neuroandriyanov/TemperatureController-CH1/hardware/README.md

# Аппаратные материалы

| Папка | Состав |
|---|---|
| `boards` | `схема_управления.pdf`, `схема_тиристор.pdf`, две спецификации XLSX |
| `boards/ssr_cpu_v2_3` | Производственные Gerber процессорной платы, слои и сверловка |
| `boards/SSR_P_V01` | Gerber силовой платы и файлы сверловки |
| `enclosure` | `cap_termoreg v9.stl`, геометрия доступной детали корпуса |
| `photos` | Реальные фотографии плат и устройства |

Имена и ревизии исходных производственных файлов сохранены. Редактируемые проекты EDA и параметрическая CAD-модель в исходном наборе не найдены; PDF/Gerber/STL не заменяют эти оригиналы. В комплект включена только имеющаяся STL-деталь, полнота печатного корпуса не утверждается.

## Отличие испытанного экземпляра

Во время калибровки 4–20 мА R17 изменён с **62 кОм по схеме на 47 кОм**. RP1 возвращён примерно на два оборота от достигнутого крайнего положения. Это изменение конкретной платы, подтверждённое ходом испытания и измерениями; PDF и BOM намеренно сохранены в исходной ревизии. Перед изготовлением новой платы пересчитайте тракт и проверьте диапазон, не считайте исходный BOM автоматически обновлённым.

Подробная привязка выводов STM32, питания, UART, MAX31856, ACS712 и AD7741 — [HARDWARE.md](../firmware/docs/HARDWARE.md). Программные защиты не заменяют независимое силовое отключение. Тепловая проверка в комплекте относится к наружной поверхности корпуса, а не к закрытому радиатору.

Аппаратные файлы: [CERN-OHL-P-2.0](../LICENSES/CERN-OHL-P-2.0.txt). Авторские фотографии: [MIT](../LICENSE).
