neuroandriyanov/TemperatureController-CH1/apps/thermal_monitor/fixtures/README.en.md

# UTi260B OCR fixture

[Русский](README.md) | **English**

Original, unchanged frame from 2026-11-05: min 22.2 °C, max 33.2 °C, center 27.9 °C.
Original photograph, MIT. Used by OCR and rotation tests without camera access.
