neuroandriyanov/TemperatureController-CH1/knowledge/OPEN_QUESTIONS.md

# Неподтверждённое и следующие исследования

1. Реальная температура закрытого радиатора и симистора: наружные термограммы не дают её. Нужен прямой доступ/датчик и учёт излучательной способности.
2. Длительный прогон на разных нагрузках, восстановление AUTO/MANUAL после полного снятия всех питаний, физическая проверка аварий и независимого отключения. Не заменять стендовый эксперимент native-тестами.
3. Сравнение внутреннего и внешнего холодного спая при одинаковом измеренном температурном поле клемм. Последний PID-опыт выполнен с внутренним CJ.
4. Причина влияния USB в калибровочных цепях: наблюдение есть, путь паразитного тока отдельно не измерялся. В термопарной серии эффект контакта не полностью отделён от общей земли.
5. Полноценная четырёхпроводная Pt100-проверка и неопределённость всей цепи. Последняя серия использовала два провода и перемычки.
6. Эвристика меню UTi260B: нужны положительные кадры меню и отрицательные обычной сцены. Нельзя просто отключить проверку во всём live-декодере, основываясь на четырёх просмотренных термограммах.
7. Оригинальные редактируемые EDA/CAD-файлы отсутствуют в комплекте. Обновление R17 в новой ревизии производства следует выполнить после проверки схемы и диапазона; старые Gerber/BOM сами не обновились.
8. Полная сверка netlist/номеров компонентов с PDF перед автоматическим импортом связей в базу сайта. Пока неизвестные связи не придуманы.
