neuroandriyanov/TemperatureController-CH1/firmware/docs/REGISTERS.en.md

# Register map 2.4

[Русский](REGISTERS.md) | **English**

The source map is generated by `scripts/register_map.py` from `app/config.def`. All addresses are zero-based; numbers are decimal. Value / divisor = physical quantity. Ranges and defaults below use transmitted integer units. This English sidecar translates descriptions without changing addresses or numerical fields.

## Holding: FC03 / FC06 / FC16

| Address | Name | Type | Divisor / unit | Default | Min…max | Purpose |
|---:|---|---|---|---:|---|---|
| 0 | `SETPOINT` | s16 | 10 / °C | 650 | -2000…18000 | Temperature setpoint |
| 1 | `TC_TYPE` | u16 | 1 / enum | 3 | 0…7 | Thermocouple: 0=B, 1=E, 2=J, 3=K, 4=N, 5=R, 6=S, 7=T |
| 2 | `CJ_MODE` | u16 | 1 / enum | 0 | 0…1 | Compensation: 0=internal MAX31856, 1=external PT100 through 4–20 mA |
| 3 | `FILTER_60HZ` | u16 | 1 / enum | 0 | 0…1 | Mains filter: 0=50 Hz, 1=60 Hz |
| 4 | `AVERAGE_LOG2` | u16 | 1 / log2 | 2 | 0…4 | MAX31856 averaging: 0/1/2/3/4 = 1/2/4/8/16 |
| 5 | `TC_TIMEOUT_MS` | u16 | 1 / ms | 3000 | 1500…10000 | Maximum thermocouple age / conversion timeout |
| 6 | `CJ_OFFSET_C100` | s16 | 100 / °C | 0 | -800…793 | Internal cold-junction offset; rounded to 0.0625 °C |
| 7 | `TC_OFFSET_C100` | s16 | 100 / °C | 0 | -10000…10000 | Final thermocouple-temperature offset |
| 8 | `KP_1000` | u16 | 1000 / %/°C | 2700 | 0…60000 | Kp |
| 9 | `KI_1000` | u16 | 1000 / %/(°C·s) | 100 | 0…60000 | Ki |
| 10 | `KD_100` | u16 | 100 / %·s/°C | 0 | 0…60000 | Kd |
| 11 | `D_FILTER_MS` | u16 | 1 / ms | 1000 | 0…10000 | Derivative-filter time constant |
| 12 | `PID_INTERVAL_MS` | u16 | 1 / ms | 500 | 100…5000 | PID calculation interval |
| 13 | `BURST_PERIOD_MS` | u16 | 1 / ms low word | 2000 | 0…65535 | Low 16 bits of PWM period; together with holding 46: 2000…300000 ms |
| 14 | `OUTPUT_LIMIT_100` | u16 | 100 / % | 10000 | 0…10000 | Output limit |
| 15 | `RAMP_C10_MIN` | u16 | 10 / °C/min | 0 | 0…10000 | Working-setpoint slew rate; 0 = unlimited |
| 16 | `PROCESS_MIN_C10` | s16 | 10 / °C | -500 | -2000…17990 | Lower process limit |
| 17 | `PROCESS_MAX_C10` | s16 | 10 / °C | 1500 | -1990…18000 | Upper process limit |
| 18 | `TOLERANCE_LOW_C10` | u16 | 10 / °C | 100 | 0…18000 | Lower tolerance for K1 relay |
| 19 | `TOLERANCE_HIGH_C10` | u16 | 10 / °C | 100 | 0…18000 | Upper tolerance for K1 relay |
| 20 | `CURRENT_GAIN_UA` | u16 | 1 / µA/count | 20350 | 1000…60000 | ACS712-30A current gain after board divider |
| 21 | `CURRENT_OFFSET_MA` | s16 | 1 / mA | 0 | -5000…5000 | RMS current offset after scaling |
| 22 | `CURRENT_NOISE_C100` | u16 | 100 / ADC count | 0 | 0…20000 | Zero-current noise; subtracted in quadrature |
| 23 | `OVERCURRENT_MA` | u16 | 1 / mA | 16000 | 100…30000 | Overcurrent threshold |
| 24 | `OVERCURRENT_MS` | u16 | 1 / ms | 200 | 0…5000 | Overcurrent delay after RMS acquisition |
| 25 | `OFF_CURRENT_MA` | u16 | 1 / mA | 500 | 0…30000 | Current threshold with output off |
| 26 | `OFF_CURRENT_MS` | u16 | 1 / ms | 1500 | 300…10000 | Fault delay for current with output off |
| 27 | `OPEN_CURRENT_MA` | u16 | 1 / mA | 0 | 0…30000 | Minimum current with heater on; 0 disables open-heater diagnosis |
| 28 | `OPEN_CURRENT_MS` | u16 | 1 / ms | 3000 | 300…30000 | Accumulated duration of valid ON windows with insufficient current; OFF excluded, normal ON current resets counter |
| 29 | `COMM_TIMEOUT_MS` | u16 | 1 / ms | 5000 | 0…60000 | Master communication timeout; 0 disables monitoring |
| 30 | `CURRENT_TIMEOUT_MS` | u16 | 1 / ms | 600 | 300…5000 | Maximum current-measurement age |
| 31 | `EXT_TEMP_4_C10` | s16 | 10 / °C | -100 | -2000…18000 | PT100 transmitter temperature at 4 mA |
| 32 | `EXT_TEMP_20_C10` | s16 | 10 / °C | 1500 | -2000…18000 | PT100 transmitter temperature at 20 mA |
| 33 | `EXT_VOLT_4_MV` | u16 | 1 / mV | 517 | 0…2450 | Measured AD7741 voltage at reference 4 mA |
| 34 | `EXT_VOLT_20_MV` | u16 | 1 / mV | 2274 | 50…2500 | Measured AD7741 voltage at reference 20 mA |
| 35 | `EXT_OFFSET_UA` | s16 | 1 / µA | 0 | -4000…4000 | Additional loop-current offset |
| 36 | `EXT_TEMP_OFFSET_C100` | s16 | 100 / °C | 0 | -10000…10000 | PT100 temperature offset |
| 37 | `EXT_TIMEOUT_MS` | u16 | 1 / ms | 1000 | 300…10000 | Maximum external-sensor age |
| 38 | `EXT_LOW_UA` | u16 | 1 / µA | 3600 | 0…4000 | Lower permitted loop-current limit |
| 39 | `EXT_HIGH_UA` | u16 | 1 / µA | 21000 | 20000…24000 | Upper permitted loop-current limit |
| 40 | `CALIBRATION_FLAGS` | u16 | 1 / bits | 0 | 0…3 | Calibration confirmation: bit0=ACS712, bit1=PT100/4–20 mA; write 1 or 3 after verification |
| 41 | `PREFERRED_MODE` | u16 | 1 / enum | 1 | 0…2 | Window selection: 0=STOP, 1=AUTO PID, 2=MANUAL; actual saved mode is holding 45 |
| 42 | `MANUAL_PRESET_100` | u16 | 100 / % | 0 | 0…10000 | Saved manual output; applied by a separate start command |
| 43 | `RELAY_FUNCTION` | u16 | 1 / enum | 1 | 0…6 | K1: 0=off, 1=in tolerance, 2=in tolerance after warm-up, 3=any fault, 4=overcurrent, 5=open heater, 6=instrument fault |
| 44 | `SOAK_SECONDS` | u16 | 1 / s | 600 | 0…65535 | Warm-up dwell after first entry into tolerance; 0=no delay |
| 45 | `POWERUP_MODE` | u16 | 1 / enum | 0 | 0…2 | Power-up mode: 0=STOP, 1=AUTO, 2=MANUAL; changed by commands 256 and saved automatically; direct write of a different value prohibited |
| 46 | `BURST_PERIOD_MS_HIGH` | u16 | 1 / ms high word | 0 | 0…4 | High 16 bits of PWM period; period = (holding46 << 16) \| holding13; 2000…300000 ms. Write both parts atomically with FC16 0…46 |

## Commands

| Address | Command | Values |
|---:|---|---|
| 256 (0x100) | Mode | 0 STOP / 1 AUTO / 2 MANUAL |
| 257 | Manual output | 0…10000 = 0…100.00 % |
| 258 | Save EEPROM | 0xA55A |
| 259 | Fault reset | 0xC1EA, STOP only and no active causes |
| 260 | Current test up to 10 s | 0xCA10; read returns remaining ms. Conditions and limits in PROTOCOL.en.md |

FC16 261…263: atomic setpoint, lower and upper tolerance (0.1 °C), saving EEPROM and retaining the current mode. Check input 37=2 and dirty=0; EEPROM writing briefly pauses output.

## Input: FC04

| Address | Name | Type | Divisor / unit | Purpose |
|---:|---|---|---|---|
| 0 | `firmware_version` | u16 | 1 / hex | 0x0205 = version 2.5 |
| 1 | `protocol_version` | u16 | 1 / hex | 0x0204 = map 2.4; previous addresses retained |
| 2 | `slave_address` | u16 | 1 / address | Active address; 0 = invalid |
| 3 | `rotary_raw` | u16 | 1 / hex | Current state of both switches |
| 4 | `mode` | u16 | 1 / enum | 0=STOP, 1=AUTO, 2=MANUAL, 3=limited current test; start only with command 260 |
| 5 | `gate` | u16 | 1 / bool | PA3 state |
| 6 | `relay` | u16 | 1 / bool | K1 state |
| 7 | `cj_mode` | u16 | 1 / enum | Selected compensation source |
| 8…9 | `active_faults` | u32 | 1 / bits | Current reasons blocking startup |
| 10…11 | `latched_faults` | u32 | 1 / bits | Latched faults |
| 12…13 | `uptime_s` | u32 | 1 / s | HAL tick / 1000; resets when tick wraps after approximately 49.7 days |
| 14…15 | `temperature_sample` | u32 | 1 / counter | Number of the MAX31856 conversion read |
| 16 | `temperature` | s16 | 10 / °C | Temperature after offset |
| 17 | `cold_junction` | s16 | 100 / °C | Compensation used by MAX31856; not the internal sensor in external mode |
| 18 | `external_temperature` | s16 | 10 / °C | PT100 temperature after scaling and offset |
| 19 | `setpoint` | s16 | 10 / °C | Requested setpoint |
| 20 | `working_setpoint` | s16 | 10 / °C | Setpoint after slew limiting |
| 21 | `output` | u16 | 100 / % | Requested output percentage |
| 22 | `current` | u16 | 1 / mA | AC RMS over 200 ms, including burst-control pauses |
| 23 | `adc_mean` | u16 | 1 / count | ADC mean, zero baseline |
| 24 | `adc_rms` | u16 | 10 / count | AC-component RMS before calibration |
| 25 | `adc_min` | u16 | 1 / count | Minimum over window |
| 26 | `adc_max` | u16 | 1 / count | Maximum over window |
| 27 | `external_voltage` | u16 | 1 / mV | AD7741 input |
| 28 | `loop_current` | u16 | 1 / µA | Converted 4–20 mA current; negative value displayed as 0 |
| 29…30 | `external_frequency` | u32 | 1 / Hz | FOUT frequency |
| 31 | `max_status` | u16 | 1 / bits | MAX31856 SR low byte; 0x100=SPI, 0x200=DRDY timeout |
| 32 | `temperature_age` | u16 | 1 / ms | Age; 65535 when invalid or saturated |
| 33 | `current_age` | u16 | 1 / ms | Current age |
| 34 | `external_age` | u16 | 1 / ms | External-sensor age |
| 35 | `measurement_flags` | u16 | 1 / bits | bit0=TC, bit1=current, bit2=external: last conversion successful; also check age and faults |
| 36 | `config_dirty` | u16 | 1 / bool | RAM settings differ from saved settings |
| 37 | `storage_status` | u16 | 1 / enum | 0=loaded, 1=pending, 2=saved, 3=defaults, 4=I2C/verification error |
| 38…39 | `saved_sequence` | u32 | 1 / counter | EEPROM record sequence |
| 40…41 | `config_revision` | u32 | 1 / counter | RAM configuration revision |
| 42…43 | `adc_overruns` | u32 | 1 / counter | Missed ADC/DMA windows |
| 44 | `pid_integral` | s16 | 100 / % | Integral term |
| 45 | `pid_derivative` | s16 | 100 / °C/s | Filtered negative PV derivative; saturates to s16 |
| 46 | `current_sensor_amperes` | u16 | 1 / A | Installed ACS712 variant: 30 |
| 47 | `calibration_flags` | u16 | 1 / bits | Copy of holding 40 |
| 48…49 | `modbus_valid` | u32 | 1 / counter | Successful requests on the queried port before the current request |
| 50…51 | `modbus_crc_errors` | u32 | 1 / counter | CRC errors on this port |
| 52…53 | `modbus_malformed` | u32 | 1 / counter | Length errors / TX timeout on this port |
| 54…55 | `modbus_exceptions` | u32 | 1 / counter | Exception replies on this port |
| 56…57 | `modbus_framing_errors` | u32 | 1 / counter | UART/gap/overflow errors or extra bytes while a frame is ready |
| 58 | `relay_function` | u16 | 1 / enum | Copy of holding 43 |
| 59 | `soak_state` | u16 | 1 / enum | 0=STOP, 1=waiting for tolerance, 2=dwell, 3=warm-up complete |
| 60 | `soak_remaining` | u16 | 1 / s | Remaining dwell; full duration before first entry into tolerance |
| 61 | `powerup_mode` | u16 | 1 / enum | Copy of holding 45; confirm saving through input 37 |
| 62 | `boot_status` | u16 | 1 / enum | 0=normal operation, 1=waiting for sensors after power-up, 2=mode restored, 3=restoration canceled |
| 63 | `config_count` | u16 | 1 / registers | Number of settings: 47 |
