neuroandriyanov/TemperatureController-CH1/firmware/docs/REGISTERS.md

# Карта регистров 2.4

Создано `scripts/register_map.py` из `app/config.def`. Все адреса нулевые, числа десятичные. Значение / делитель = физическая величина. Диапазоны и defaults ниже даны в передаваемых целых единицах.

## Holding: FC03 / FC06 / FC16

| Адрес | Имя | Тип | Делитель / единица | Default | Min…max | Назначение |
|---:|---|---|---|---:|---|---|
| 0 | `SETPOINT` | s16 | 10 / °C | 650 | -2000…18000 | Уставка температуры |
| 1 | `TC_TYPE` | u16 | 1 / enum | 3 | 0…7 | Термопара: 0=B, 1=E, 2=J, 3=K, 4=N, 5=R, 6=S, 7=T |
| 2 | `CJ_MODE` | u16 | 1 / enum | 0 | 0…1 | Компенсация: 0=внутренняя MAX31856, 1=внешняя PT100 через 4–20 мА |
| 3 | `FILTER_60HZ` | u16 | 1 / enum | 0 | 0…1 | Сетевой фильтр: 0=50 Гц, 1=60 Гц |
| 4 | `AVERAGE_LOG2` | u16 | 1 / log2 | 2 | 0…4 | Усреднение MAX31856: 0/1/2/3/4 = 1/2/4/8/16 |
| 5 | `TC_TIMEOUT_MS` | u16 | 1 / ms | 3000 | 1500…10000 | Максимальный возраст термопары / тайм-аут преобразования |
| 6 | `CJ_OFFSET_C100` | s16 | 100 / °C | 0 | -800…793 | Поправка внутреннего холодного спая; округляется к 0,0625 °C |
| 7 | `TC_OFFSET_C100` | s16 | 100 / °C | 0 | -10000…10000 | Поправка итоговой температуры термопары |
| 8 | `KP_1000` | u16 | 1000 / %/°C | 2700 | 0…60000 | Kp |
| 9 | `KI_1000` | u16 | 1000 / %/(°C·s) | 100 | 0…60000 | Ki |
| 10 | `KD_100` | u16 | 100 / %·s/°C | 0 | 0…60000 | Kd |
| 11 | `D_FILTER_MS` | u16 | 1 / ms | 1000 | 0…10000 | Постоянная фильтра производной |
| 12 | `PID_INTERVAL_MS` | u16 | 1 / ms | 500 | 100…5000 | Период расчёта PID |
| 13 | `BURST_PERIOD_MS` | u16 | 1 / ms low word | 2000 | 0…65535 | Младшие 16 бит периода ШИМ; совместно с holding 46: 2000…300000 мс |
| 14 | `OUTPUT_LIMIT_100` | u16 | 100 / % | 10000 | 0…10000 | Ограничение мощности |
| 15 | `RAMP_C10_MIN` | u16 | 10 / °C/min | 0 | 0…10000 | Скорость изменения рабочей уставки; 0 = без ограничения |
| 16 | `PROCESS_MIN_C10` | s16 | 10 / °C | -500 | -2000…17990 | Нижний технологический предел |
| 17 | `PROCESS_MAX_C10` | s16 | 10 / °C | 1500 | -1990…18000 | Верхний технологический предел |
| 18 | `TOLERANCE_LOW_C10` | u16 | 10 / °C | 100 | 0…18000 | Нижний допуск для реле K1 |
| 19 | `TOLERANCE_HIGH_C10` | u16 | 10 / °C | 100 | 0…18000 | Верхний допуск для реле K1 |
| 20 | `CURRENT_GAIN_UA` | u16 | 1 / µA/count | 20350 | 1000…60000 | Коэффициент тока ACS712-30A после делителя платы |
| 21 | `CURRENT_OFFSET_MA` | s16 | 1 / mA | 0 | -5000…5000 | Поправка RMS тока после пересчёта |
| 22 | `CURRENT_NOISE_C100` | u16 | 100 / ADC count | 0 | 0…20000 | Шум при нулевом токе; вычитается по квадратам |
| 23 | `OVERCURRENT_MA` | u16 | 1 / mA | 16000 | 100…30000 | Порог перегрузки |
| 24 | `OVERCURRENT_MS` | u16 | 1 / ms | 200 | 0…5000 | Задержка перегрузки после получения RMS |
| 25 | `OFF_CURRENT_MA` | u16 | 1 / mA | 500 | 0…30000 | Порог тока при выключенном выходе |
| 26 | `OFF_CURRENT_MS` | u16 | 1 / ms | 1500 | 300…10000 | Задержка ошибки тока при выключенном выходе |
| 27 | `OPEN_CURRENT_MA` | u16 | 1 / mA | 0 | 0…30000 | Минимальный ток включённого нагревателя; 0 отключает диагностику обрыва |
| 28 | `OPEN_CURRENT_MS` | u16 | 1 / ms | 3000 | 300…30000 | Накопленное время достоверных ON-окон без достаточного тока; OFF не учитывается, нормальный ON-ток сбрасывает счётчик |
| 29 | `COMM_TIMEOUT_MS` | u16 | 1 / ms | 5000 | 0…60000 | Потеря связи с мастером; 0 отключает контроль |
| 30 | `CURRENT_TIMEOUT_MS` | u16 | 1 / ms | 600 | 300…5000 | Максимальный возраст измерения тока |
| 31 | `EXT_TEMP_4_C10` | s16 | 10 / °C | -100 | -2000…18000 | Температура преобразователя PT100 при 4 мА |
| 32 | `EXT_TEMP_20_C10` | s16 | 10 / °C | 1500 | -2000…18000 | Температура преобразователя PT100 при 20 мА |
| 33 | `EXT_VOLT_4_MV` | u16 | 1 / mV | 517 | 0…2450 | Измеренное напряжение AD7741 при эталонных 4 мА |
| 34 | `EXT_VOLT_20_MV` | u16 | 1 / mV | 2274 | 50…2500 | Измеренное напряжение AD7741 при эталонных 20 мА |
| 35 | `EXT_OFFSET_UA` | s16 | 1 / µA | 0 | -4000…4000 | Дополнительная поправка тока петли |
| 36 | `EXT_TEMP_OFFSET_C100` | s16 | 100 / °C | 0 | -10000…10000 | Поправка температуры PT100 |
| 37 | `EXT_TIMEOUT_MS` | u16 | 1 / ms | 1000 | 300…10000 | Максимальный возраст внешнего датчика |
| 38 | `EXT_LOW_UA` | u16 | 1 / µA | 3600 | 0…4000 | Нижняя допустимая граница тока петли |
| 39 | `EXT_HIGH_UA` | u16 | 1 / µA | 21000 | 20000…24000 | Верхняя допустимая граница тока петли |
| 40 | `CALIBRATION_FLAGS` | u16 | 1 / bits | 0 | 0…3 | Подтверждение калибровки: bit0=ACS712, bit1=PT100/4–20 мА; после проверки записать 1 или 3 |
| 41 | `PREFERRED_MODE` | u16 | 1 / enum | 1 | 0…2 | Выбор в окне: 0=STOP, 1=AUTO PID, 2=MANUAL; действующий сохранённый режим — holding 45 |
| 42 | `MANUAL_PRESET_100` | u16 | 100 / % | 0 | 0…10000 | Сохранённая ручная мощность; применяется отдельной командой запуска |
| 43 | `RELAY_FUNCTION` | u16 | 1 / enum | 1 | 0…6 | K1: 0=выключено, 1=в допуске, 2=в допуске после прогрева, 3=любая ошибка, 4=перегрузка, 5=обрыв нагревателя, 6=ошибка прибора |
| 44 | `SOAK_SECONDS` | u16 | 1 / s | 600 | 0…65535 | Выдержка прогрева после первого попадания в допуск; 0=без задержки |
| 45 | `POWERUP_MODE` | u16 | 1 / enum | 0 | 0…2 | Режим после питания: 0=STOP, 1=AUTO, 2=MANUAL; меняется командами 256 и сохраняется автоматически, прямая запись другого значения запрещена |
| 46 | `BURST_PERIOD_MS_HIGH` | u16 | 1 / ms high word | 0 | 0…4 | Старшие 16 бит периода ШИМ; период = (holding46 << 16) | holding13; 2000…300000 мс. Обе части записывать атомарно FC16 0…46 |

## Команды

| Адрес | Команда | Значения |
|---:|---|---|
| 256 (0x100) | Режим | 0 STOP / 1 AUTO / 2 MANUAL |
| 257 | Ручная мощность | 0…10000 = 0…100,00 % |
| 258 | Сохранить EEPROM | 0xA55A |
| 259 | Сброс аварии | 0xC1EA, только STOP и отсутствие активных причин |
| 260 | Тест тока до 10 с | 0xCA10; чтение — оставшиеся мс. Условия и ограничения в PROTOCOL.md |

FC16 261…263: атомарно уставка, нижний и верхний допуск (0,1 °C), с сохранением EEPROM и текущего режима. Проверить input 37=2 и dirty=0; запись даёт краткую паузу выхода на время EEPROM.

## Input: FC04

| Адрес | Имя | Тип | Делитель / единица | Назначение |
|---:|---|---|---|---|
| 0 | `firmware_version` | u16 | 1 / hex | 0x0205 = версия 2.5 |
| 1 | `protocol_version` | u16 | 1 / hex | 0x0204 = карта 2.4; прежние адреса сохранены |
| 2 | `slave_address` | u16 | 1 / address | Действующий адрес; 0 = недопустим |
| 3 | `rotary_raw` | u16 | 1 / hex | Текущее состояние двух переключателей |
| 4 | `mode` | u16 | 1 / enum | 0=STOP, 1=AUTO, 2=MANUAL, 3=ограниченный тест тока; запуск только командой 260 |
| 5 | `gate` | u16 | 1 / bool | Состояние PA3 |
| 6 | `relay` | u16 | 1 / bool | Состояние K1 |
| 7 | `cj_mode` | u16 | 1 / enum | Выбранный источник компенсации |
| 8…9 | `active_faults` | u32 | 1 / bits | Текущие причины запрета запуска |
| 10…11 | `latched_faults` | u32 | 1 / bits | Зафиксированные аварии |
| 12…13 | `uptime_s` | u32 | 1 / s | HAL tick / 1000; сброс при переполнении tick примерно через 49,7 суток |
| 14…15 | `temperature_sample` | u32 | 1 / counter | Номер прочитанного преобразования MAX31856 |
| 16 | `temperature` | s16 | 10 / °C | Температура после поправки |
| 17 | `cold_junction` | s16 | 100 / °C | Компенсация, использованная MAX31856; при внешнем режиме это не внутренний датчик |
| 18 | `external_temperature` | s16 | 10 / °C | Температура PT100 после масштабирования и поправки |
| 19 | `setpoint` | s16 | 10 / °C | Заданная уставка |
| 20 | `working_setpoint` | s16 | 10 / °C | Уставка после ограничения скорости |
| 21 | `output` | u16 | 100 / % | Заданная мощность |
| 22 | `current` | u16 | 1 / mA | AC RMS за 200 мс, включая паузы пакетного управления |
| 23 | `adc_mean` | u16 | 1 / count | Среднее АЦП, нулевая линия |
| 24 | `adc_rms` | u16 | 10 / count | RMS переменной составляющей до калибровки |
| 25 | `adc_min` | u16 | 1 / count | Минимум за окно |
| 26 | `adc_max` | u16 | 1 / count | Максимум за окно |
| 27 | `external_voltage` | u16 | 1 / mV | Вход AD7741 |
| 28 | `loop_current` | u16 | 1 / µA | Пересчитанный ток 4–20 мА; отрицательное значение отображается как 0 |
| 29…30 | `external_frequency` | u32 | 1 / Hz | Частота FOUT |
| 31 | `max_status` | u16 | 1 / bits | Младший байт SR MAX31856; 0x100=SPI, 0x200=DRDY timeout |
| 32 | `temperature_age` | u16 | 1 / ms | Возраст; 65535 при недостоверности или насыщении |
| 33 | `current_age` | u16 | 1 / ms | Возраст тока |
| 34 | `external_age` | u16 | 1 / ms | Возраст внешнего датчика |
| 35 | `measurement_flags` | u16 | 1 / bits | bit0=TC, bit1=current, bit2=external: последнее преобразование успешно; также проверять возраст и аварии |
| 36 | `config_dirty` | u16 | 1 / bool | Настройки в RAM отличаются от сохранённых |
| 37 | `storage_status` | u16 | 1 / enum | 0=загружено, 1=ожидание, 2=сохранено, 3=defaults, 4=ошибка I2C/проверки |
| 38…39 | `saved_sequence` | u32 | 1 / counter | Номер записи EEPROM |
| 40…41 | `config_revision` | u32 | 1 / counter | Номер изменения настроек в RAM |
| 42…43 | `adc_overruns` | u32 | 1 / counter | Пропуски окон ADC/DMA |
| 44 | `pid_integral` | s16 | 100 / % | Интегральная составляющая |
| 45 | `pid_derivative` | s16 | 100 / °C/s | Отфильтрованная отрицательная производная PV; насыщается до s16 |
| 46 | `current_sensor_amperes` | u16 | 1 / A | Установленный вариант ACS712: 30 |
| 47 | `calibration_flags` | u16 | 1 / bits | Повтор holding 40 |
| 48…49 | `modbus_valid` | u32 | 1 / counter | Успешные запросы на читаемом порту до текущего запроса |
| 50…51 | `modbus_crc_errors` | u32 | 1 / counter | CRC ошибки этого порта |
| 52…53 | `modbus_malformed` | u32 | 1 / counter | Ошибки длины/тайм-аут TX этого порта |
| 54…55 | `modbus_exceptions` | u32 | 1 / counter | Ответы исключения этого порта |
| 56…57 | `modbus_framing_errors` | u32 | 1 / counter | Ошибки UART/пауз/переполнения/лишние байты во время готового кадра |
| 58 | `relay_function` | u16 | 1 / enum | Повтор holding 43 |
| 59 | `soak_state` | u16 | 1 / enum | 0=STOP, 1=ожидание допуска, 2=выдержка, 3=прогрев завершён |
| 60 | `soak_remaining` | u16 | 1 / s | Оставшееся время выдержки; до первого допуска полное время |
| 61 | `powerup_mode` | u16 | 1 / enum | Повтор holding 45; факт сохранения проверять по input 37 |
| 62 | `boot_status` | u16 | 1 / enum | 0=обычная работа, 1=ожидание датчиков после питания, 2=режим восстановлен, 3=восстановление отменено |
| 63 | `config_count` | u16 | 1 / registers | Число настроек: 47 |
