neuroandriyanov/TemperatureController-CH1/apps/thermal_monitor/fixtures/README.md

# UTi260B OCR fixture

**Русский** | [English](README.en.md)

Реальный неизменённый кадр 05.11.2026: min 22,2 °C, max 33,2 °C, center 27,9 °C.
Авторский снимок, MIT. Используется в тестах OCR и поворота без доступа к камере.
