neuroandriyanov/TemperatureController-CH1/apps/thermal_monitor/fixtures/uti260b_osd.png

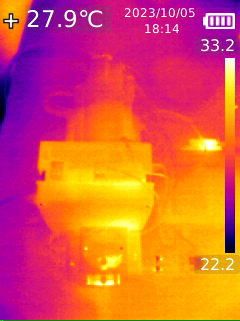
apps/thermal_monitor/fixtures/uti260b_osd.png
