neuroandriyanov/TemperatureController-CH1/hardware/photos/1.JPG

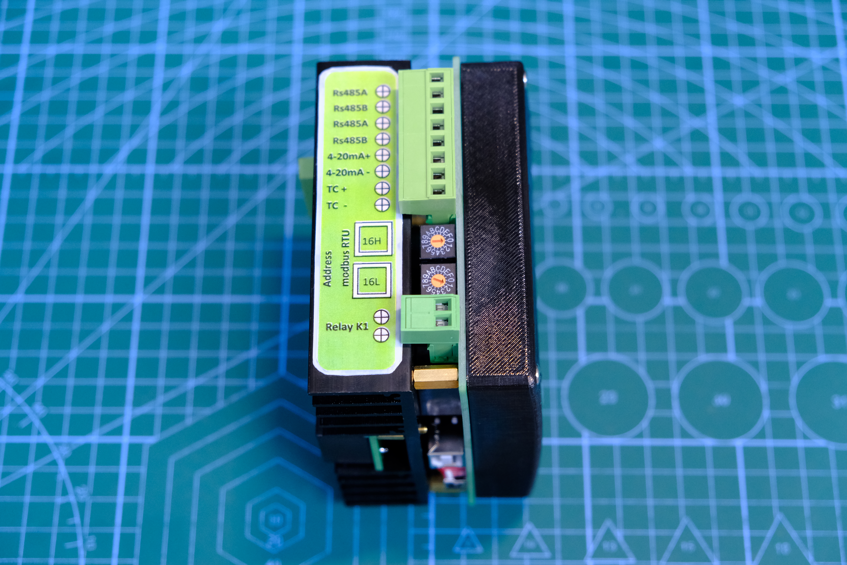
hardware/photos/1.JPG
