neuroandriyanov/TemperatureController-CH1/hardware/photos/2.JPG

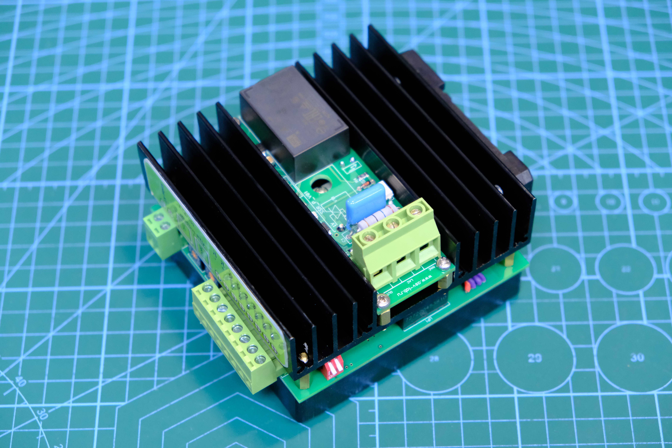
hardware/photos/2.JPG
