neuroandriyanov/TemperatureController-CH1/hardware/photos/3.JPG

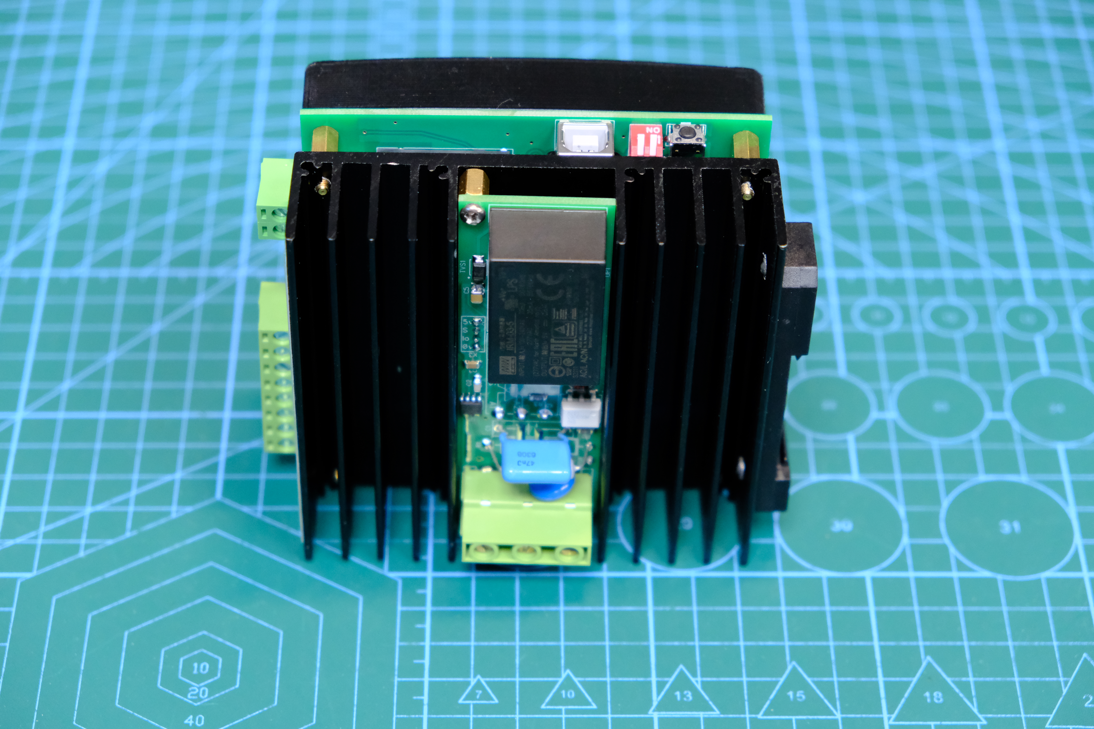
hardware/photos/3.JPG
