neuroandriyanov/TemperatureController-CH1/hardware/photos/4.JPG

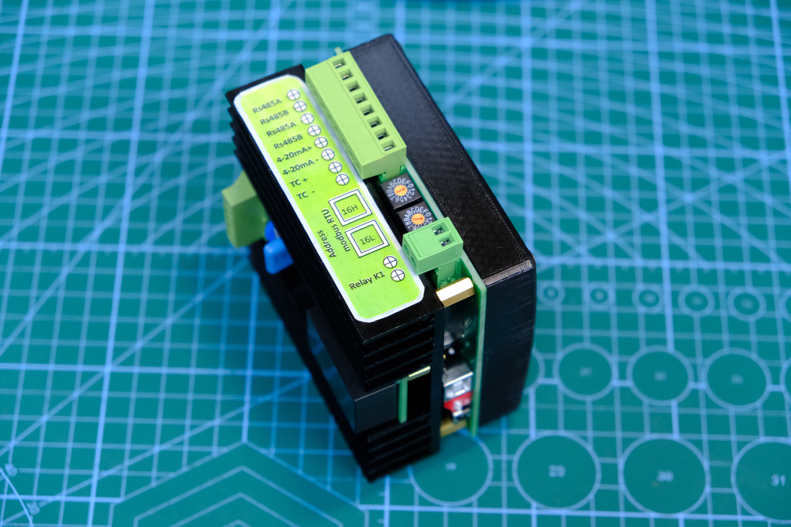
hardware/photos/4.JPG
