neuroandriyanov/TemperatureController-CH1/hardware/photos/20230220_220734.jpg

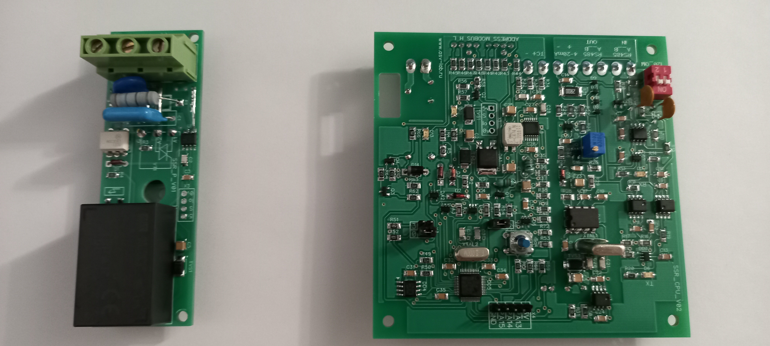
hardware/photos/20230220_220734.jpg
