neuroandriyanov/TemperatureController-CH1/hardware/photos/20230220_220859.jpg

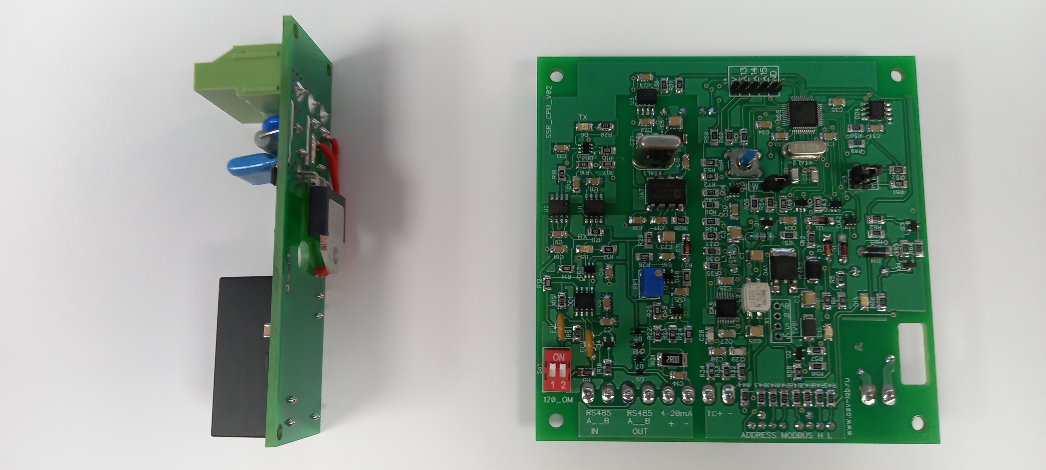
hardware/photos/20230220_220859.jpg
