neuroandriyanov/TemperatureController-CH1/hardware/photos/DSCF0177.JPG

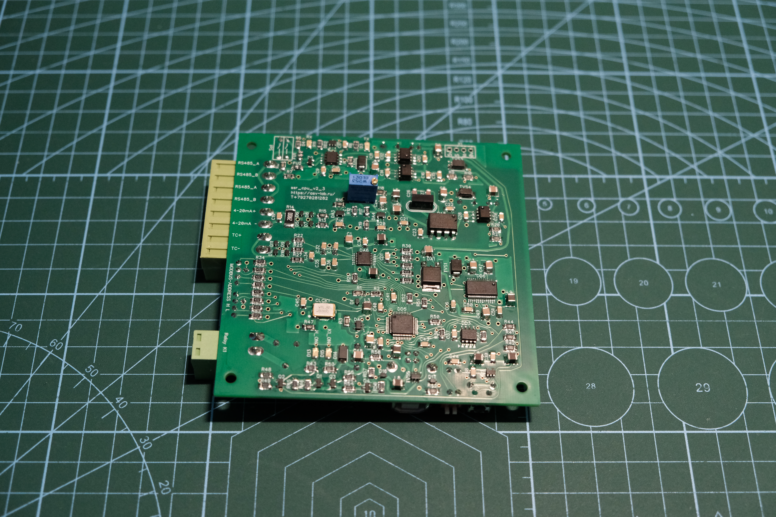
hardware/photos/DSCF0177.JPG
