neuroandriyanov/TemperatureController-CH1/hardware/photos/DSCF0179.JPG

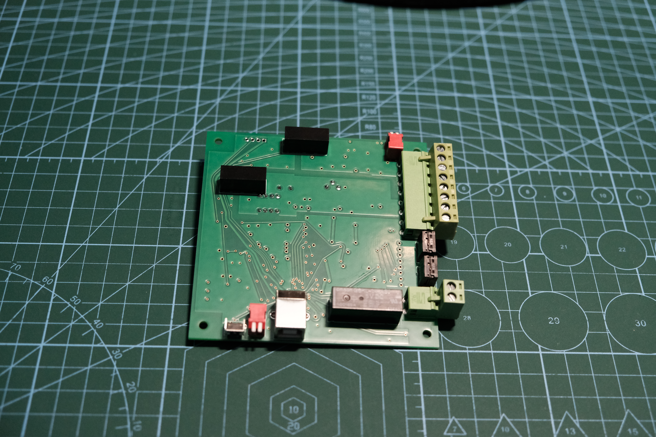
hardware/photos/DSCF0179.JPG
