neuroandriyanov/TemperatureController-CH1/hardware/boards/bom_ssr_cpu_v2_3.en.xlsx

Item | Qty | Ref Des | Manufacturer | Man.Part num. | Description | Package | Type
1 | 1 |  |  | AT24C512BN | EEPROM | SO8 | SMT
2 | 11 | D1,D5,D6,D7,D8,D9,D10,D11,D12,D16,D17 |  | BAT60JFILM | DIODE | SOD323 | SMT
3 | 1 | DD6 |  | FT232RL | USB/COM | SSOP-28 | SMT
4 | 3 | U1,U2,U3 |  | HCPL0710-500 | optocoupler | SO8 | SMT
5 | 2 | Q2,Q4 |  | IRLML2803 | MOSFET | SOT23 | SMT
6 | 2 | Q1,Q3 |  | IRLML5203 | MOSFET | SOT23 | SMT
7 | 4 | D3,D4,D13,D15 |  | KPTD3216 | LED | 1206 | SMT
8 | 1 | DD1 |  | MAX13487 | RS485 | SO8 | SMT
9 | 1 | DA6 |  | MAX31856 | ADC | TSSOP14 | SMT
10 | 2 | FU1,FU2 |  | MF-NSMF050-2 | FUSE | 1206 | SMT
11 | 3 | DA2,DA3,DA4 |  | OPA333 | Amplifiers | SOT23-5 | SMT
12 | 1 | DD4 |  | RS806-2.93YF5 | WATCHDOG | SOT23-5 | SMT
13 | 1 | D2 |  | SM712 | TVS DIODE | SOT23 | SMT
14 | 1 | DD2 |  | SN74LVC2G14DBVR | Dual Schmitt-Trigger Inverter | SOT23-6 | SMT
15 | 1 | DD5 |  | STM32F030C8T6 | MCU | LQFP48 | SMT
16 | 1 | TVS5 |  | USBLC6-2SC6 | TVS USB | SOT23-6 | SMT
17 | 1 | CLCK1 |  | WTL7K85435FO | OSCILLATOR | 7*5 | SMT
18 | 29 | C9,C11,C12,C13,C14,C15,C16,C17,C18,C19,C20,C21,C22,C23,C28,C29,C30,C31,C37,C38,C39,C40,C41,C42,C43,C44,C45,C50,C34 |  | 0,1uF | CAPACITOR | 1206 | SMT
19 | 7 | C10,C32,C33,C35,C36,C46,C51 |  | 0,47uF | CAPACITOR | 1206 | SMT
20 | 2 | C26,C27 |  | 260pF | CAPACITOR | 1206 | SMT
21 | 2 | Sa2,Sa3 |  | FR01FR16H-S | SWITCHER 16H |  | THR
22 | 3 | R1,R3,R19 |  | 1K 1% | RESISTOR | 1206 | SMT
23 | 1 | R2 |  | 1,5K | RESISTOR | 1206 | SMT
24 | 10 | R4,R12,R13,R15,R16,R41,R42,R44,R47,R59 |  | 10K 1% | RESISTOR | 1206 | SMT
25 | 3 | R5,R7,R22 |  | 2K | RESISTOR | 1206 | SMT
26 | 2 | R6,R18 |  | 120 | RESISTOR | 1206 | SMT
27 | 4 | R8,R11,R43,R53 |  | 560 | RESISTOR | 1206 | SMT
28 | 2 | R9,R20 |  | 5,5K | RESISTOR | 1206 | SMT
29 | 1 | R21 |  | 3,3K | RESISTOR | 1206 | SMT
30 | 1 | R17 |  | 62K | RESISTOR | 1206 | SMT
31 | 28 | R23,R24,R26,R28,R29,R30,R31,R32,R33,R34,R35,R36,R37,R38,R39,R40,R45,R46,R48,R49,R50,R51,R52,R54,R55,R56,R57,R58 |  | 4,3K | RESISTOR | 1206 | SMT
32 | 2 | R25,R27 |  | 1 | RESISTOR | 1206 | SMT
33 | 13 | C1,C2,C3,C4,C5,C6,C7,C8,C24,C25,C47,C48,C49 |  | 47uF | CAPACITOR | 1210 | SMT
34 | 9 | L1,L2,L3,L4,L5,L6,L7,L8,L9 |  | CBC3225T220MR | INDUCTION | 1210 | SMT
35 | 1 | D14 |  | RS1M | DIODE | DO214 | SMT
36 | 1 | TVS1 |  | SMBJ3V3 | TVS | do-214aa | SMT
37 | 3 | TVS2,TVS3,TVS4 |  | SMBJ5.0A | TVS | DO-214AA | SMT
38 | 1 | DA5 |  | AD7741BNZ | VOLT/FREQ | DIP8 | THR
39 | 1 | PR1 |  | 3296W-1-253LF | POT |  | THR
40 | 1 | XTAL1 |  | CRB500E | CRYSTAL |  | THR
41 | 1 | R14 |  | 2 OM 1% | RESISTOR | 2512 | SMT
42 | 1 | DA1 |  | LM1117DTX-3.3 | LDO | TO252 | SMT
43 | 1 | X3 |  | 2EDGR-5.08-02P-14-00AH | CONNECTOR |  | THR
44 | 1 | X2 |  | 5EHDR-08P | CONNECTOR |  | THR
45 | 2 | Sa1,Sa5 |  | DS1040-02RT | DIP-SWITCH |  | THR
46 | 1 | K1 |  | G6RL-14-ASI-5VDC | RELAY |  | THR
47 | 1 | Sa4 |  | L-KLS7-TS6606-5.0-180 | BUTTON |  | THR
48 | 2 | UP1,UP2 |  | TMH0505S | DC-DC |  | THR
49 | 1 | X4 |  | USBB-1J | CONNECTOR |  | THR
50
51
52
53
54
55
56
57
58
59
60
61
62
63
64
65
66
67
68
69
70
71
72
73
74
75
76
77
78
79
80
81
82
83
84
85
86
87
88
89
90
91
92
93
94
95
96
97
98
99
100
