neuroandriyanov/TemperatureController-CH1/hardware/boards/Specification_SSR_P_V01.en.xlsx

Designator | Value | Type | Qty | Unit price | Price
C2 | 0.01uf | CAP1206 | 1 | 16 | 16
C3 | 0.1uF | CAP1206 | 1 | 12 | 12
C5 | 47uF | CAP1210 | 1 | 88 | 88
R2,R3,R4 | 560 | RES1206 | 3 | 6 | 18
U1 | ACS712 | ACS712 | 1 | 730 | 730
TVS1 | SMBJ5.0A | SMBJ5.0A | 1 | 8 | 8
U2 | MOC3083 | MOC3083 | 1 | 25 | 25
D1 | 1N4148 | 1N4148 | 1 | 2 | 2
RU1 | S10K275 | S10K275 | 1 | 30 | 30
C1 | 0.047 | K73-17 | 1 | 16 | 16
R1 | 16 | RES2W | 1 | 11 | 11
VT1 | BTA41800B | BTA41800B | 1 | 990 | 990
X1 | DG950-03 | DG950-03 | 1 | 53 | 53
UP1 | IRM-03-5 | IRM-03-5 | 1 | 420 | 420
PCHSN-8, PCB spacer | PCHSN-8 | PCHSN-8 | 3 | 11 | 33
M3 steel spacer screws, 5 mm thread (KLS8-M3X5-A) | KLS8-M3X5-A | KLS8-M3X5-A | 4 | 11 | 44
Heatsink | HS 145-100 | HS 145-100 | 1 | 470 | 470
PCB | SSR_P_V01 | SSR_P_V01 | 1 | 400 | 400
DIN-rail mounting clip, China | DIN-rail clip | DIN-rail clip | 1 | 100 | 100
10 mm rivets for the DIN-rail clip | 4*10 rivets | 4*10 rivets | 2 | 10 | 20
 |  |  |  |  | 0
 |  |  |  |  | 0
 |  |  |  |  | 0
 |  |  |  |  | 0
 |  |  |  |  | 0
 |  |  |  |  | 0
 |  |  |  |  | 0
 |  |  |  |  | 0
 |  |  |  |  | 0
 |  |  |  | Total | 3486
