neuroandriyanov/TemperatureController-CH1/hardware/boards/Specification_SSR_P_V01.xlsx

Обозначение | Значение | Тип | Кол-во | Цена/шт | Цена
C2 | 0.01uf | CAP1206 | 1 | 16 | 16
C3 | 0.1uF | CAP1206 | 1 | 12 | 12
C5 | 47uF | CAP1210 | 1 | 88 | 88
R2,R3,R4 | 560 | RES1206 | 3 | 6 | 18
U1 | ACS712 | ACS712 | 1 | 730 | 730
TVS1 | SMBJ5.0A | SMBJ5.0A | 1 | 8 | 8
U2 | MOC3083 | MOC3083 | 1 | 25 | 25
D1 | 1N4148 | 1N4148 | 1 | 2 | 2
RU1 | S10K275 | S10K275 | 1 | 30 | 30
C1 | 0.047 | K73-17 | 1 | 16 | 16
R1 | 16 | RES2W | 1 | 11 | 11
VT1 | BTA41800B | BTA41800B | 1 | 990 | 990
X1 | DG950-03 | DG950-03 | 1 | 53 | 53
UP1 | IRM-03-5 | IRM-03-5 | 1 | 420 | 420
PCHSN-8, Стойка для печатных плат | PCHSN-8 | PCHSN-8 | 3 | 11 | 33
Винты для стоек М3 (сталь) резьба 5мм (KLS8-M3X5-A) | KLS8-M3X5-A | KLS8-M3X5-A | 4 | 11 | 44
Радиатор | HS 145-100 | HS 145-100 | 1 | 470 | 470
Плата | SSR_P_V01 | SSR_P_V01 | 1 | 400 | 400
Крепление на din Китай | крепл.на din | крепл.на din | 1 | 100 | 100
Клепки для крепления зажима на дин рейку 10мм | клепки 4*10 | клепки 4*10 | 2 | 10 | 20
 |  |  |  |  | 0
 |  |  |  |  | 0
 |  |  |  |  | 0
 |  |  |  |  | 0
 |  |  |  |  | 0
 |  |  |  |  | 0
 |  |  |  |  | 0
 |  |  |  |  | 0
 |  |  |  |  | 0
 |  |  |  | сумма | 3486
