neuroandriyanov/TemperatureController-CH1/hardware/enclosure/cap_termoreg v9.stl

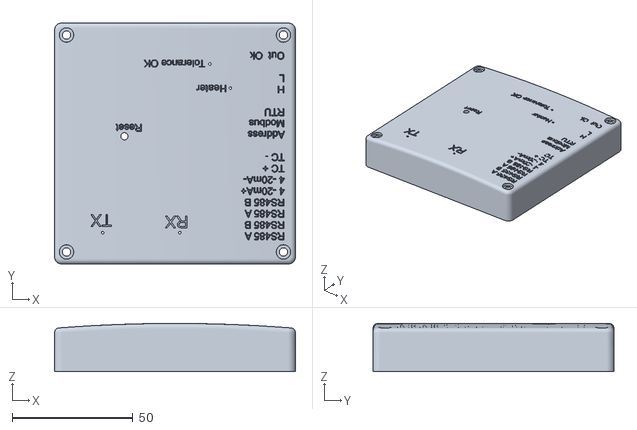
[picture p12: CAD file, 2026-11-07]
hardware/enclosure/cap_termoreg v9.stl
100.0 x 100.0 x 20.0
