neuroandriyanov/TemperatureController-CH1/measurements/2026-11-06_thermocouple_input/photos/setup/color.png

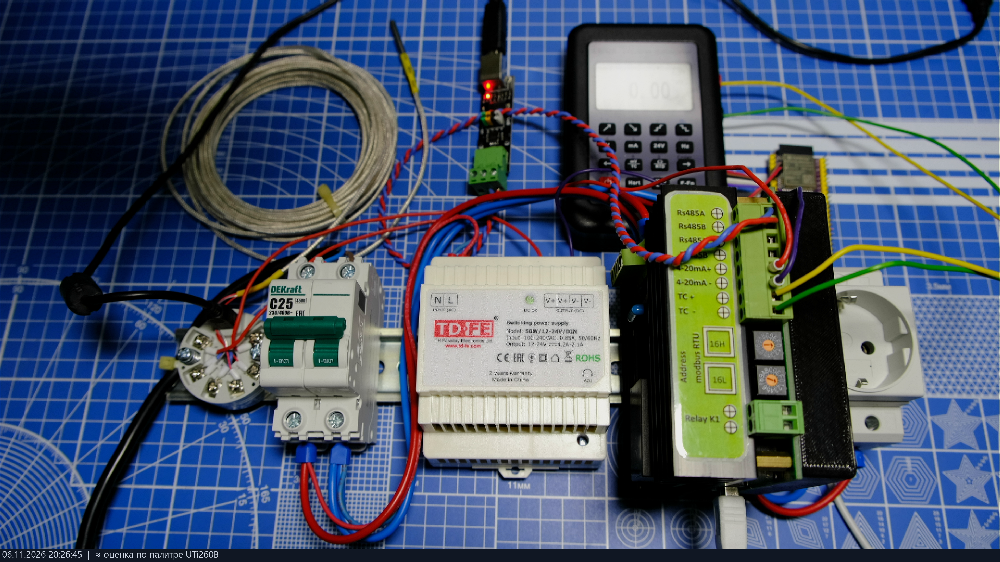
measurements/2026-11-06_thermocouple_input/photos/setup/color.png
