neuroandriyanov/TemperatureController-CH1/measurements/2026-11-06_thermocouple_input/photos/setup/thermal.png

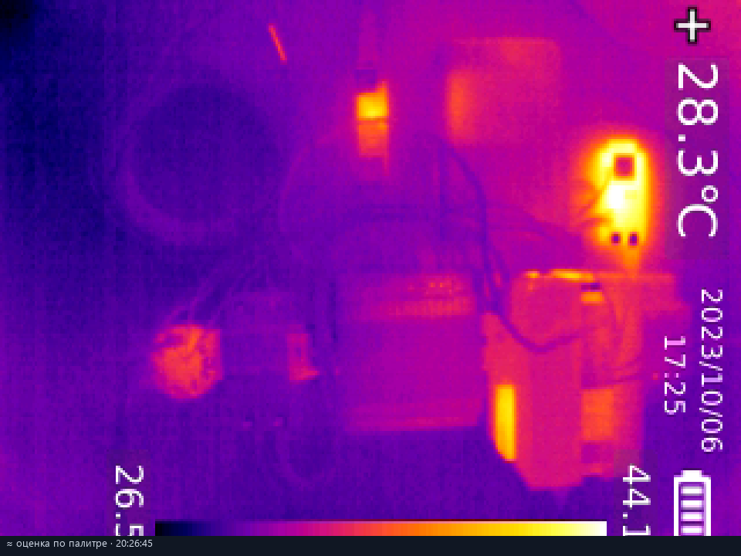
measurements/2026-11-06_thermocouple_input/photos/setup/thermal.png
