neuroandriyanov/TemperatureController-CH1/firmware/docs/VALIDATION.md

# Состояние проверок прошивки 2.5

**Русский** | [English](VALIDATION.en.md)

Актуальная версия — 2.5.0, протокол 2.4, 47 параметров. [Проверка переносимого комплекта](../../docs/VALIDATION.md), [первичные измерения](../../measurements/README.md).

На стенде 07.11.2026 образ записан с проверкой всех 65 536 байт Flash. BIN: 35 724 байта; SHA-256 `93f7d02f7603307c50841d9e405e86e70ddb5882950252f9a2b05ca6973c633c`. Полный readback Flash с заполнением FF: `68ebdfc8e78374ed5f44b6bdbc55db1117552cb5b0d0bf76ed40153438bbd8ab`. Личные резервные копии и служебные журналы загрузки не публикуются. После обновления проверено сохранение прежних настроек и калибровок, firmware=0x0205, protocol=0x0204, STOP без ошибок.

Проверки C-ядра: 54 590 утверждений, включая CRC/границы Modbus, 50 000 случайных пакетов, измерения, PID, anti-windup, тайм-ауты, реле, восстановление режимов, EEPROM и имитацию 120 точек потери питания при записи. Это тесты прикладного кода на ПК, не электрической периферии STM32.

Аппаратные данные включают восемь типов термопар (прошивка 2.2), прямую петлю и Pt100/НПТ (2.3), ток (2.4/2.5), работу PID на 60 °C (2.5). Все эти серии содержат указание своей версии и условий; их нельзя выдавать за повтор всех испытаний на 2.5. Во втором опыте достигнуто более 10 минут наблюдения после выхода к уставке, в конце сохранён STOP.

## Остающиеся проверки

- Электрические уровни PA8, тайминги SPI/DRDY, ADC/DMA, задержка физического выключения PA3 и реакция силовой части на неисправности.
- Снятие управления при принудительном зависании, проверка внешнего WDI и IWDG на плате, максимум использования стека.
- Полная матрица аварий и контролируемая проверка токовых порогов. Короткое замыкание программной защитой не подтверждено.
- Восстановление AUTO/MANUAL после реального отключения всех источников питания с нагрузкой. Ранее RESET проверял загрузку EEPROM; USB мог сохранять питание MCU.
- Независимое аварийное отключение, изоляция и температура скрытого радиатора/симистора. Наружная термограмма этого не доказывает.
- Повторяемость на нескольких платах и нагрузках, метрологическая неопределённость, длительная устойчивость, сравнительная серия внутренней и внешней компенсации при одинаковом температурном режиме клемм.

Новая плата стартует с POWERUP_MODE=STOP и неподтверждённой калибровкой. Уже настроенная плата восстанавливает сохранённое состояние при готовых датчиках. Утверждение «любое включение всегда STOP» к версии 2.5 неприменимо.
