neuroandriyanov/TemperatureController-CH1/firmware/docs/CALIBRATION.md

# Калибровка и настройка

**Русский** | [English](CALIBRATION.en.md)

Все адреса ниже — holding, если не указано input. Калибровка выполняется в STOP. Запись коэффициентов изменяет RAM; отдельная команда SAVE сохраняет их в EEPROM. Исходные значения не означают, что конкретная плата уже откалибрована.

## ACS712, вариант 30 А

Плата содержит делитель 0,6 перед ADC; номинально для варианта 30 А чувствительность 66 мВ/А. При VDDA=3,3 В исходный коэффициент:

```text
gain = 3,3 / (4095 × 0,6 × 0,066) ≈ 0,02035 А / count
holding 20 = 20350 мкА / count
```

Это расчёт по номиналам схемы и [паспорту ACS712](https://www.allegromicro.com/~/media/Files/Datasheets/ACS712-Datasheet.ashx), а не измерение VDDA или фактического усиления. Вариант 30 А рассчитан на мгновенный диапазон около ±30 А; это не обещание измерения синусоидальных 30 А RMS без ограничения пиков. Для синусоиды ±30 А соответствуют примерно 21,2 А RMS. Номинальный ток исходной нагрузки 2,5 кВт / 220 В — около 11,36 А RMS.

ADC получает 5000 отсчётов/с. Каждые 200 мс вычисляются среднее и RMS переменной составляющей. Среднее удаляется автоматически, поэтому результат предназначен для **переменного тока нагревателя**, а не для DC:

```text
r = sqrt(mean(x²) − mean(x)²)
I_mA = max(0, sqrt(max(0, r² − noise²)) × gain_µA / 1000 + offset_mA)
```

1. При отсутствии тока и после прогрева платы прочитать input 23…26. Input 23 — нулевая линия, 24 / 10 — RMS шума в counts, 25/26 — минимальный/максимальный ADC. Не должно быть отсчётов у границ 0/4095.
2. Установить holding 21=0 и 22=`round(100 × RMS_шума)`. Для шума 3,5 count это 350. Если требуется измерять очень малые токи, проверить, что такая компенсация не скрывает их.
3. Подать через измерительный канал известный стабильный AC ток от контролируемого внешнего источника и сравнить с true-RMS прибором. На этом этапе STOP относится к выходу регулятора; измерять ток можно независимо от его управления. Записать `r = input24/10`, эталон `Iref_mA`.
4. Вычислить `gain_µA = round(1000 × Iref_mA / sqrt(r² − noise²))` и записать holding 20. Для двух ненулевых точек можно вычислить линейный коэффициент и остаточную поправку holding 21: `gain=1000×(I2−I1)/(R2−R1)`, `offset=I1−R1×gain/1000`, где R уже очищен от шума. Проверить результат минимум ещё в одной точке.
5. Проверить порог 23 и задержку 24, ток при выключенном выходе 25/26. Default 16000 мА — предварительный порог для исходной нагрузки, не аппаратная характеристика защиты. Установить значения по реальному стенду.
6. После успешной проверки установить bit0 в holding 40. Например, значение 1 подтверждает ток, 3 — оба канала. Изменение gain/offset/noise затем автоматически снимает bit0. Прочитать свежую телеметрию и сохранить настройки.

Для первичной проверки установленного ACS712 без отдельного источника тока прошивка 2.4 предоставляет ограниченный тест нагрузки командой 260, см. [условия и пределы](PROTOCOL.md#первичный-тест-тока-команда-260-прошивка-24). Он не подменяет подтверждение калибровки. Сначала снять нулевой шум при STOP, затем во время короткого непрерывного включения сопоставить сырой RMS ADC с внешними AC true-RMS клещами. После автоматического STOP вычислить gain, сохранить коэффициент с bit0=0, повторить контроль и только по результатам выставить bit0. Во время пакетного AUTO показания клещей и 200-мс окна регулятора могут усредняться за разные интервалы; их нельзя использовать как синхронную калибровочную пару.

При пакетном управлении input22 — RMS за текущее 200-мс окно, включая выключенные участки; это не ток только включённого нагревателя и не расчёт ватт. Изменение duty меняет этот RMS. Для точной калибровки нужен устойчивый ток.

## PT100 через преобразователь 4–20 мА

PT100 подключается к своему преобразователю. Прошивка измеряет выходную петлю через аналоговый тракт платы и AD7741; напрямую сопротивление PT100 она не измеряет.

Два независимых этапа настройки:

| Адрес | Параметр |
|---:|---|
| 31 | Температура при 4 мА, ×10 °C |
| 32 | Температура при 20 мА, ×10 °C |
| 33 | Измеренное напряжение AD7741 при эталонных 4 мА, мВ |
| 34 | Измеренное напряжение AD7741 при эталонных 20 мА, мВ |
| 35 | Дополнительная поправка тока петли, мкА |
| 36 | Поправка температуры внешнего датчика, ×100 °C |
| 37 | Максимальный возраст внешнего датчика, мс |
| 38/39 | Допустимые нижняя/верхняя границы петли, мкА |

Defaults −10…150 °C и 517/2274 мВ взяты как начальные ориентиры из прежнего проекта. Они **не подтверждают фактическую настройку установленного преобразователя**. Введите его реальный диапазон. Для 0…100 °C: holding31=0, holding32=1000.

При эталонных 4 мА запишите input27 в holding33; при 20 мА — в holding34. Между точками требуется минимум 50 мВ. Затем проверьте 8/12/16 мА, отсутствие насыщения и монотонность. В input28 ожидаются 4000…20000 мкА, input18 показывает пересчитанную температуру. Небольшую остаточную погрешность петли можно убрать регистром 35, погрешность температуры — регистром 36. Эти поправки не заменяют проверку линейности.

Формулы:

```text
V_mV = ((fOUT / 500000) − 0,05) × 2500 / 0,40
I_µA = 4000 + (V_mV − V4) × 16000 / (V20 − V4) + offset_µA
T_°C = T4 + (I_µA − 4000) × (T20 − T4) / 16000 + offset_°C
```

Формула частоты основана на [паспорте AD7741](https://www.analog.com/media/en/technical-documentation/data-sheets/ad7741.pdf), при fCLK=500 кГц и VREF=2,5 В, принятых для существующей платы. Input29/30 позволяет проверить саму частоту. Если напряжение достигает предела AD7741 или частота исчезает, калибровкой это не исправить: нужно проверить аналоговый тракт и уровни PA8.

После проверки установите bit1 holding40. Изменение диапазона, напряжений или поправок снимает этот бит. Для внешней компенсации необходимо значение holding40=3, для внутренней достаточно bit0=1.

## Холодный спай и тип термопары

Holding1 задаёт B/E/J/K/N/R/S/T, holding2 выбирает внутреннюю либо внешнюю компенсацию. Для внутренней поправки используется holding6 с шагом ввода 0,01 °C и аппаратным округлением к 0,0625 °C. Для итоговой температуры термопары — holding7 с шагом 0,01 °C. Телеметрия PV округляется до 0,1 °C; это формат, а не заявленная точность датчика.

При подключении калибратора медными проводами учитывайте его компенсацию холодного спая: на вход подаётся `Eтип(Tзад) − Eтип(CJкалибратора)`, а MAX31856 добавляет `Eтип(CJрегулятора)`. Выбор CJ калибратора по показанию самого регулятора позволяет проверить тракт термо-ЭДС и линеаризацию, но не является независимой проверкой абсолютной точности внутреннего CJ.

В [стендовом исследовании 06.11.2026](../../measurements/2026-11-06_thermocouple_input/README.md) при одновременном USB-подключении калибратора и регулятора точка K 100 °C давала 86,6…165,3 °C. После отключения USB прошивки USB-порта загрузки при сохранении штатного питания и изолированного RS-485 получено 99,4…99,6 °C. Короткая перемычка TC+–TC− давала устойчивые 31,3…31,5 °C. Для этой конфигурации проверку калибратором выполняем без USB-порта загрузки. Устойчивая работа получена без USB-порта загрузки; предполагаемый механизм через общий уровень входов отдельно не измерялся. Обратного опыта с повторным подключением USB-порта загрузки не было, а провода после перемычки переподключались, поэтому вклад повторного контакта окончательно не отделён. Нулевой статус MAX31856 присутствовал и в шумной серии, поэтому он не заменяет проверку подключения источника.

PT100 должен измерять температуру реального перехода термопарных проводов на медь. При внешнем режиме MAX31856 использует записанную температуру PT100, а input17 показывает именно использованную компенсацию. Независимое внутреннее измерение CJ в этом режиме недоступно.

Регистровый формат MAX31856 позволяет закодировать −64…127,984375 °C, но его допустимый рабочий диапазон CJ уже: **−55…125 °C для E/J/K/N/T, −50…125 °C для R/S, 0…125 °C для B**. Внешнее значение вне соответствующего диапазона блокирует нагрев, а не ограничивается молча. Преобразователь с диапазоном до 150 °C допустимо настроить, но температура холодного спая 150 °C для этой реализации MAX31856 недопустима. Основание — описание SR и CJ в [MAX31856 datasheet](https://www.analog.com/media/en/technical-documentation/data-sheets/max31856.pdf).

## PID

Используется обычная параллельная форма, мощность в процентах:

```text
error = working_setpoint − temperature
P = Kp × error
I_new = I + Ki × error × dt
D_raw = −(temperature − previous_temperature) / dt
D_filter += dt / (tau + dt) × (D_raw − D_filter)
output = clamp(P + I + Kd × D_filter, 0, output_limit)
```

Интегрирование условное: оно запрещено, если увеличивает насыщение, и разрешено при выходе из насыщения. Интеграл дополнительно ограничен ±output_limit. Производная берётся по измерению, поэтому скачок уставки не создаёт derivative kick. Время dt реальное, по системному таймеру. На STOP/ошибке PID сбрасывается. Переход в AUTO начинает новый расчёт, без обещания безударного переключения с MANUAL.

Holding8/9/10 — Kp/1000, Ki/1000, Kd/100 в единицах `%/°C`, `%/(°C·с)`, `%·с/°C`. Holding11 — постоянная фильтра D; 12 — период расчёта. Величины Ki и Kd здесь имеют другой смысл, чем в старой программе; переносить прежние числа напрямую нельзя.

Начальные Kp=2,7, Ki=0,1, Kd=0 — отправная точка, не настроенный PID для конкретного устройства. Начать с небольшой разрешённой мощности и проверенных технологических пределов, определить реакцию объекта, затем подобрать Kp и Ki; D добавлять при подтверждённой необходимости. Для медленного нагревателя обычно полезнее сначала устойчивый PI. Автонастройка в эту версию не включена.

Регистром 15 можно ограничить изменение рабочей уставки в 0,1 °C/мин. При начале AUTO рабочая уставка берётся равной текущей температуре; при 0 ограничение отключено. Регистром 13 задаётся период пакетного включения; исходно 2000 мс. Это управление оптосимистором с переходом через ноль, не фазовое регулирование.

В 2.2 диагностика отсутствия тока (27/28) суммирует время достоверных ON-окон разных пакетов. OFF-время не учитывается, нормальный ON-ток и STOP сбрасывают накопление. Окно RMS должно целиком находиться после переключения, а выход должен оставаться ON не менее 250 мс. На очень коротких импульсах обнаружение не гарантируется; default27=0 отключает проверку. Диагностика тока при OFF также требует полного стабильного окна и наиболее показательна в STOP. Функция реле 5 показывает текущую или зафиксированную ошибку недостаточного тока.
