neuroandriyanov/TemperatureController-CH1/apps/calibrator_lb02a/lb02aphoto/IMG_20261104_200203.jpg

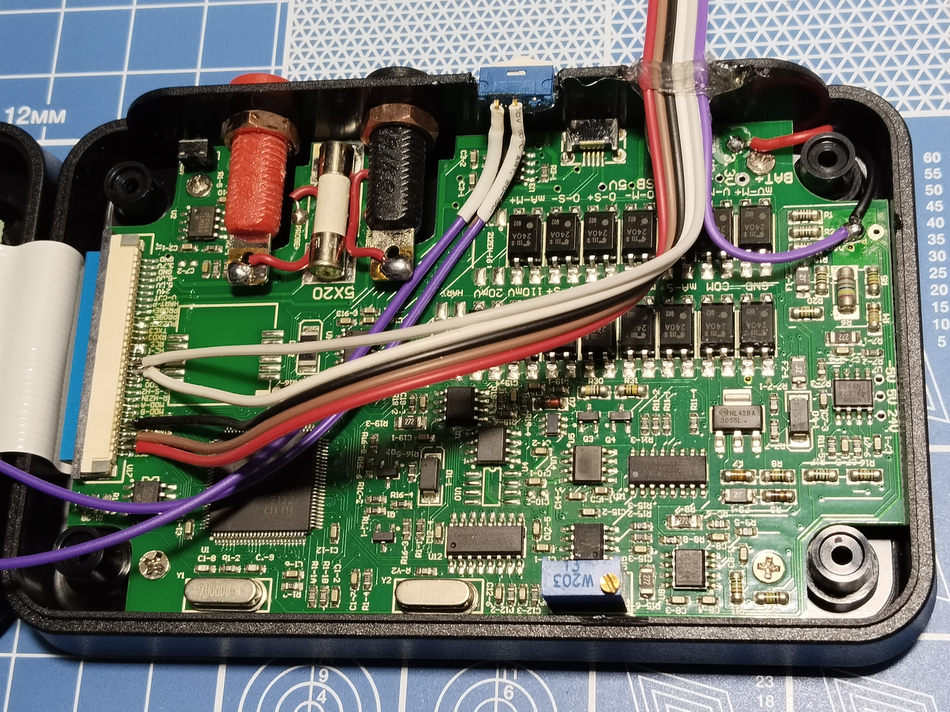
apps/calibrator_lb02a/lb02aphoto/IMG_20261104_200203.jpg
