neuroandriyanov/TemperatureController-CH1/apps/calibrator_lb02a/lb02aphoto/IMG_20261104_200235.jpg

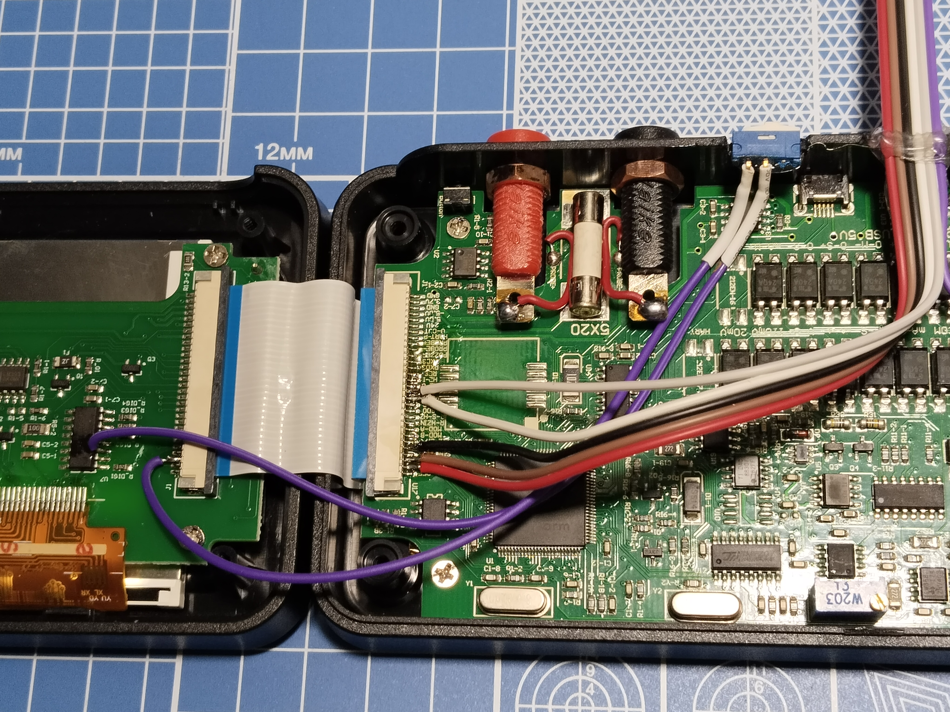
apps/calibrator_lb02a/lb02aphoto/IMG_20261104_200235.jpg
