neuroandriyanov/TemperatureController-CH1/apps/calibrator_lb02a/lb02aphoto/IMG_20261104_205123.jpg

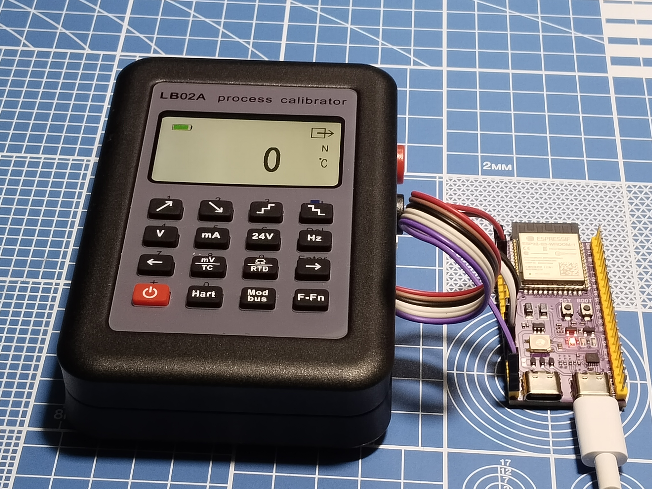
apps/calibrator_lb02a/lb02aphoto/IMG_20261104_205123.jpg
