neuroandriyanov/TemperatureController-CH1/measurements/2026-11-06_pt100_npt_loop/photos/npt_final_recovered/thermal.png

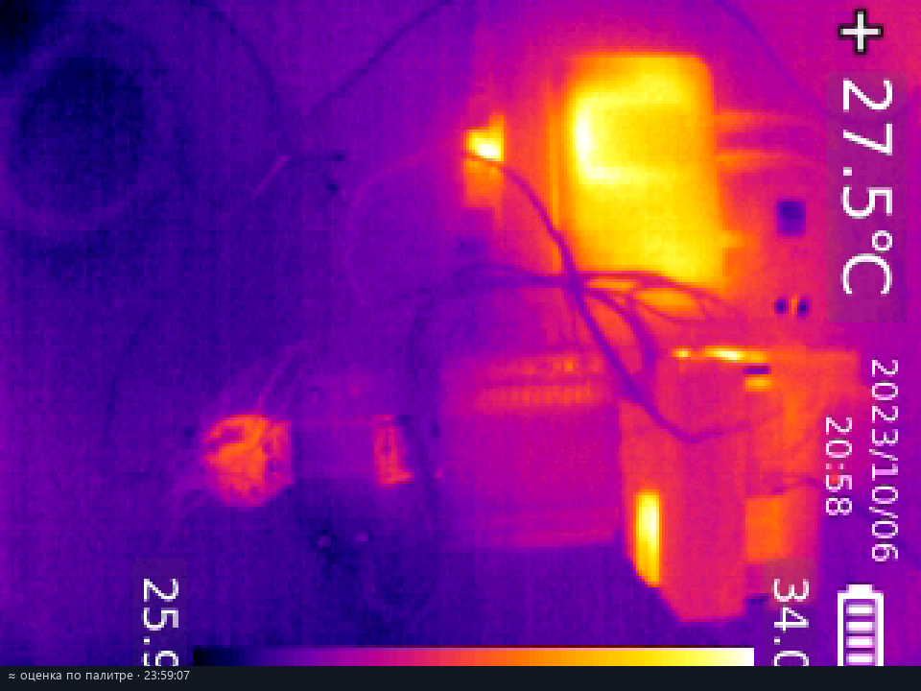
measurements/2026-11-06_pt100_npt_loop/photos/npt_final_recovered/thermal.png
