neuroandriyanov/TemperatureController-CH1/measurements/2026-11-07_heater_60c/photos/current_stronger_20s_01_on_4s/color.png

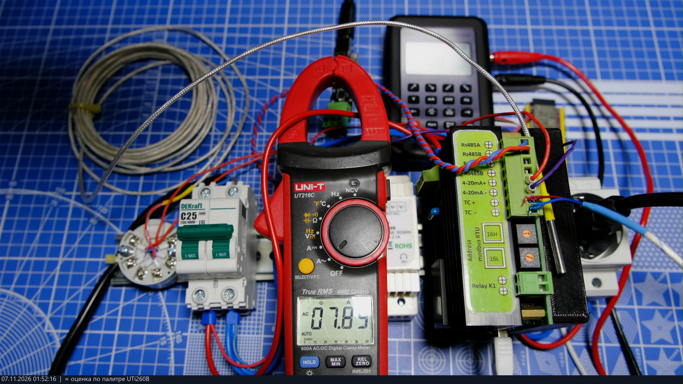
measurements/2026-11-07_heater_60c/photos/current_stronger_20s_01_on_4s/color.png
