neuroandriyanov/TemperatureController-CH1/measurements/2026-11-07_heater_60c/photos/pid60_hold5_02_007_heat/thermal.png

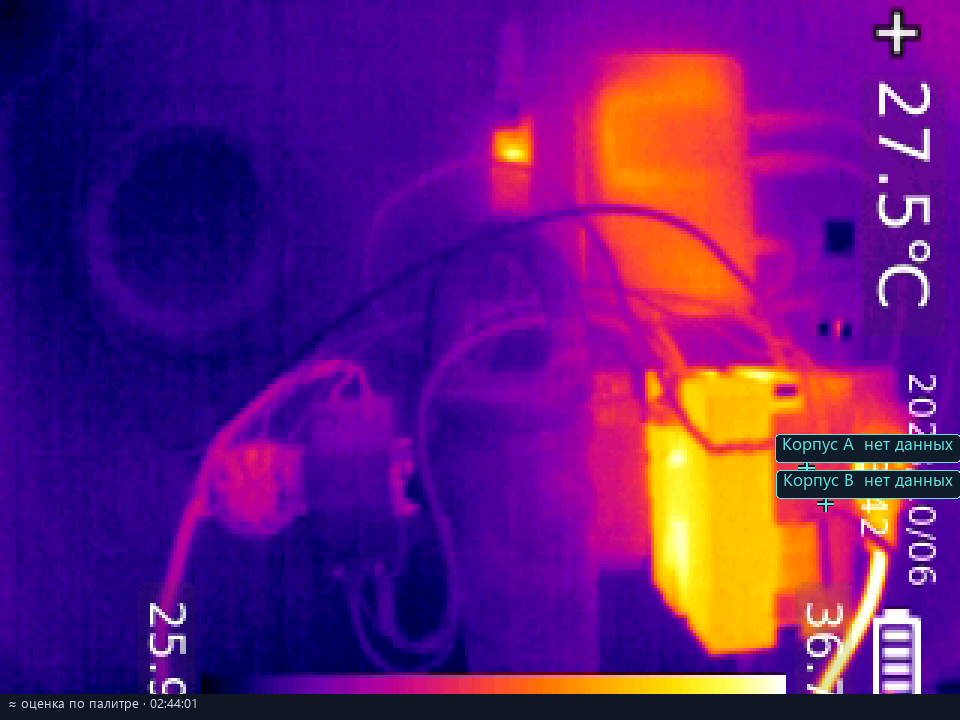
measurements/2026-11-07_heater_60c/photos/pid60_hold5_02_007_heat/thermal.png
