neuroandriyanov/TemperatureController-CH1/measurements/2026-11-07_heater_60c/photos/raw_thermal_hold/20261107_025048.png

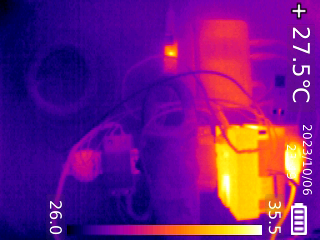
measurements/2026-11-07_heater_60c/photos/raw_thermal_hold/20261107_025048.png
