neuroandriyanov/TemperatureController-CH1/measurements/2026-11-07_heater_60c/plots/en/pid60_hold5_01_hold.png

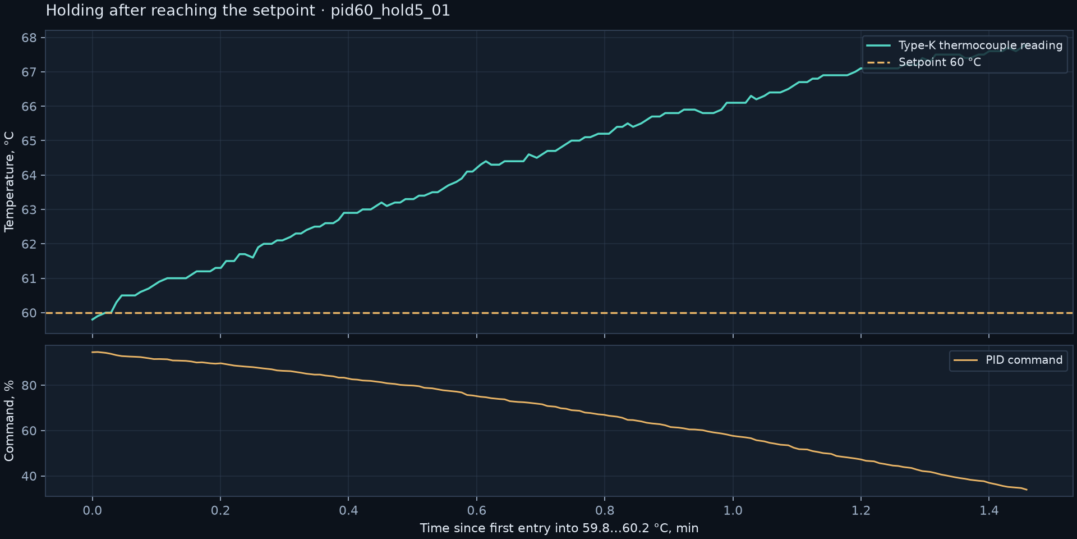
measurements/2026-11-07_heater_60c/plots/en/pid60_hold5_01_hold.png
