neuroandriyanov/TemperatureController-CH1/hardware/boards/схема_управления.pdf

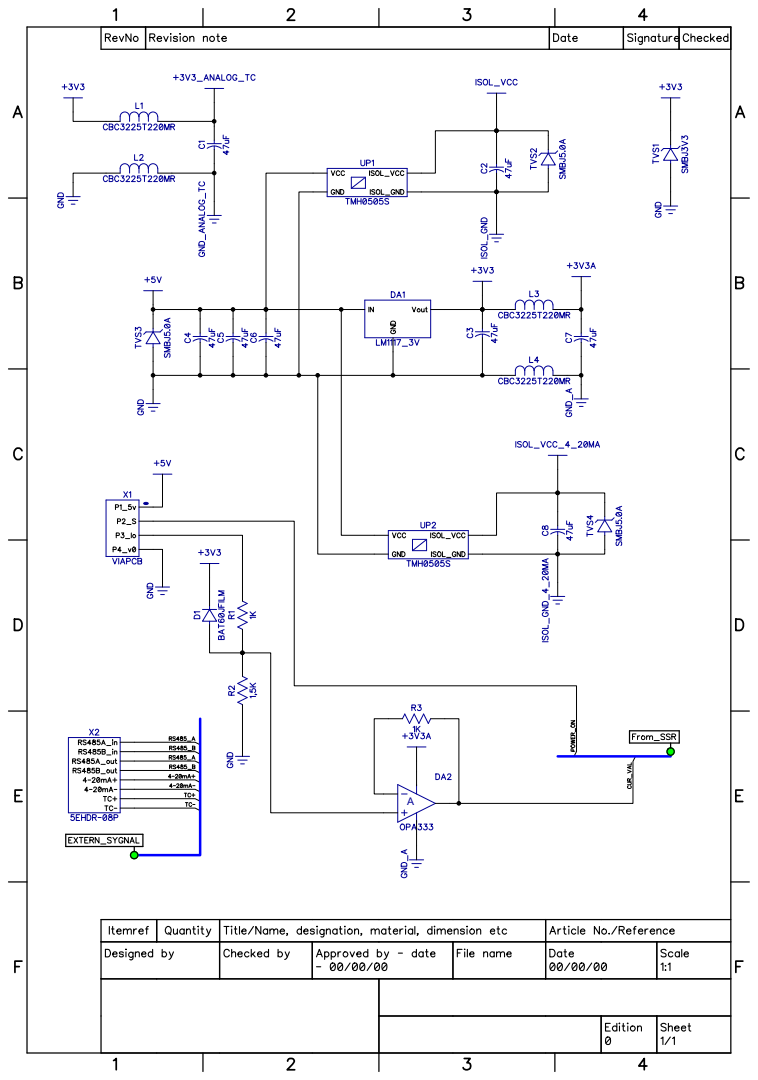
[picture p40: page 1]

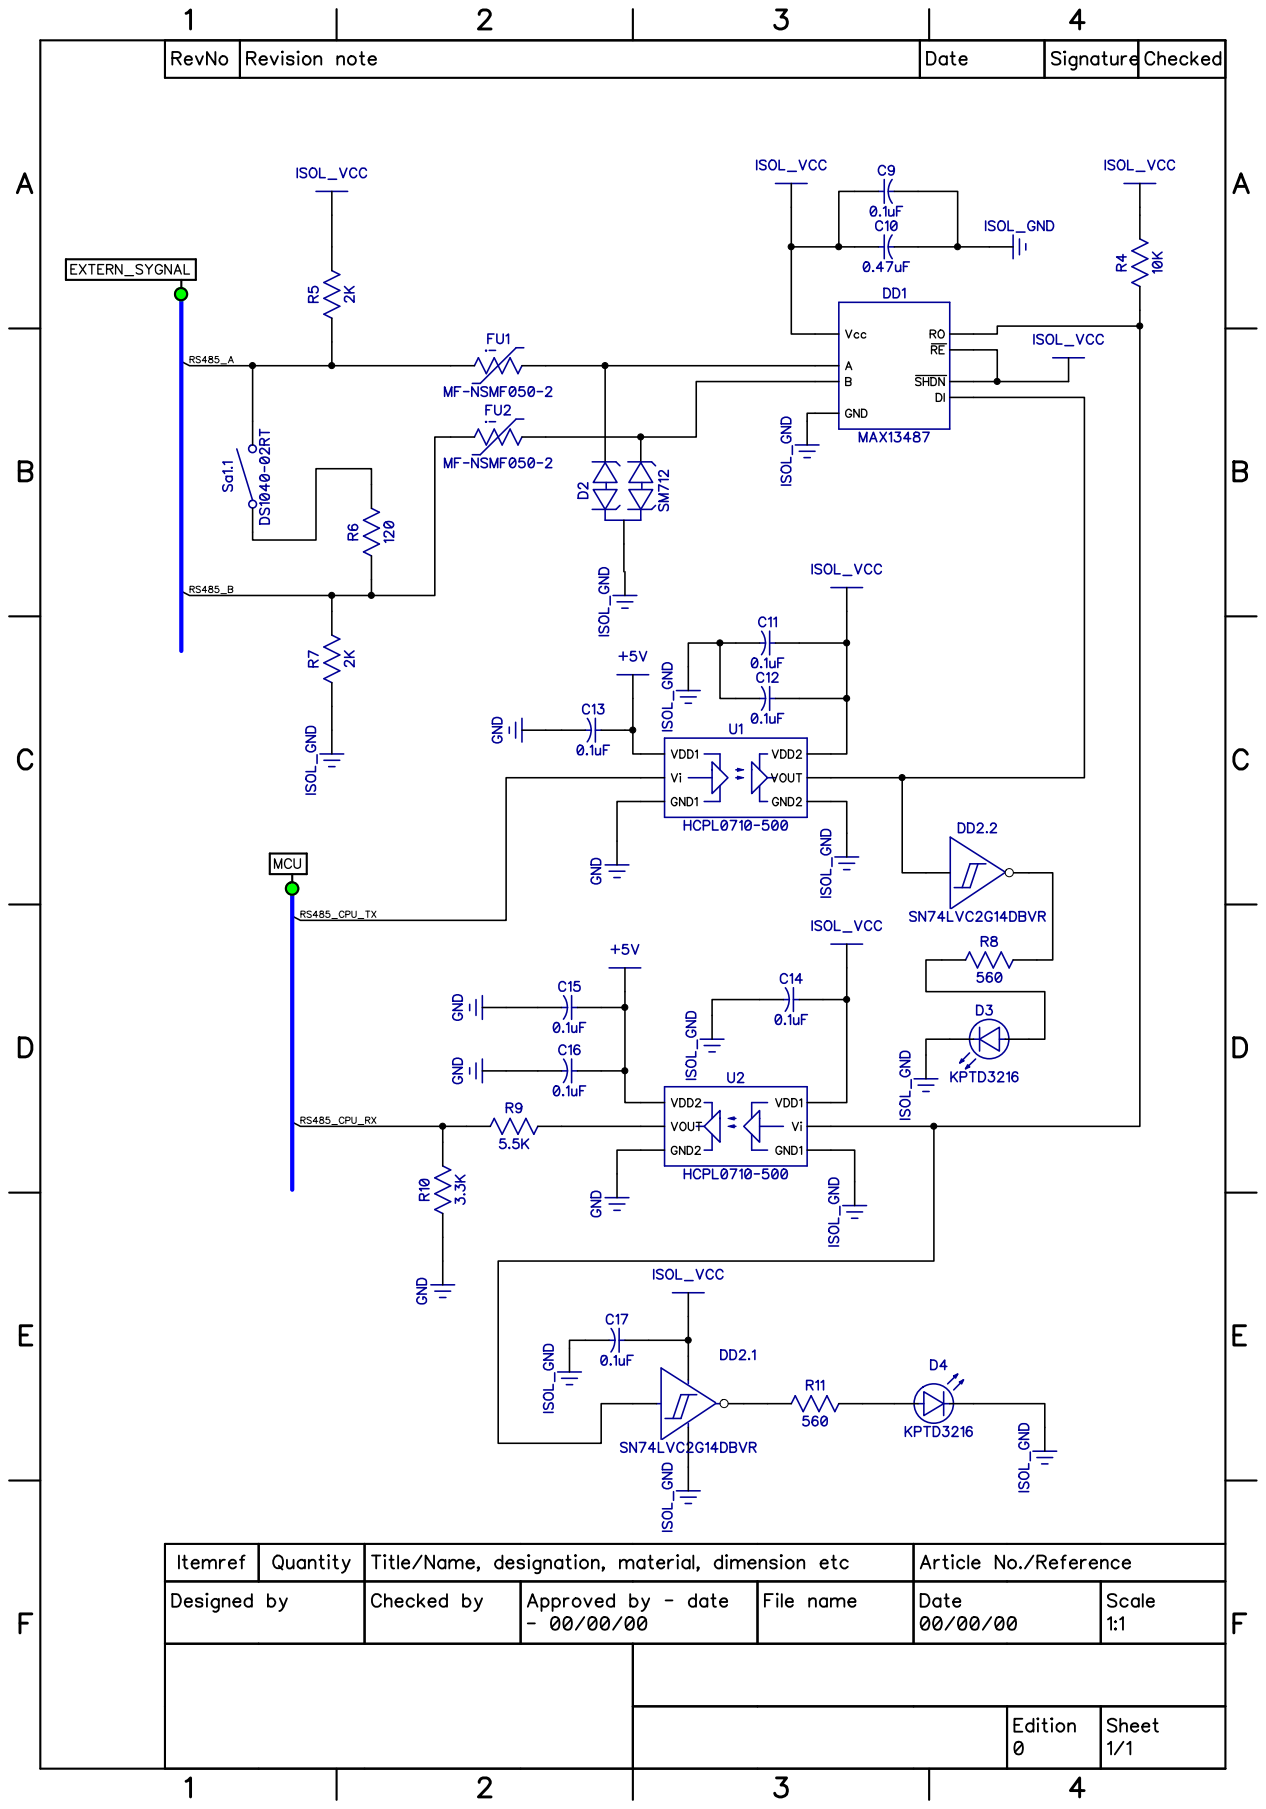
[picture p41: page 2]

A

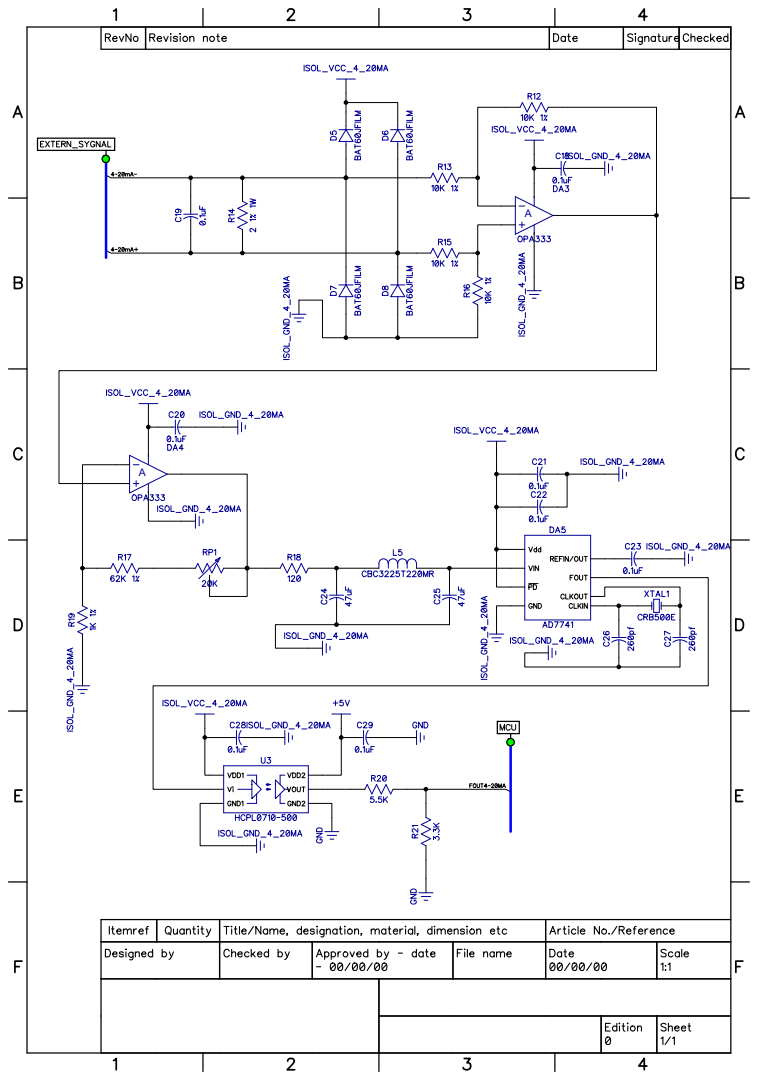
[picture p42: page 3]

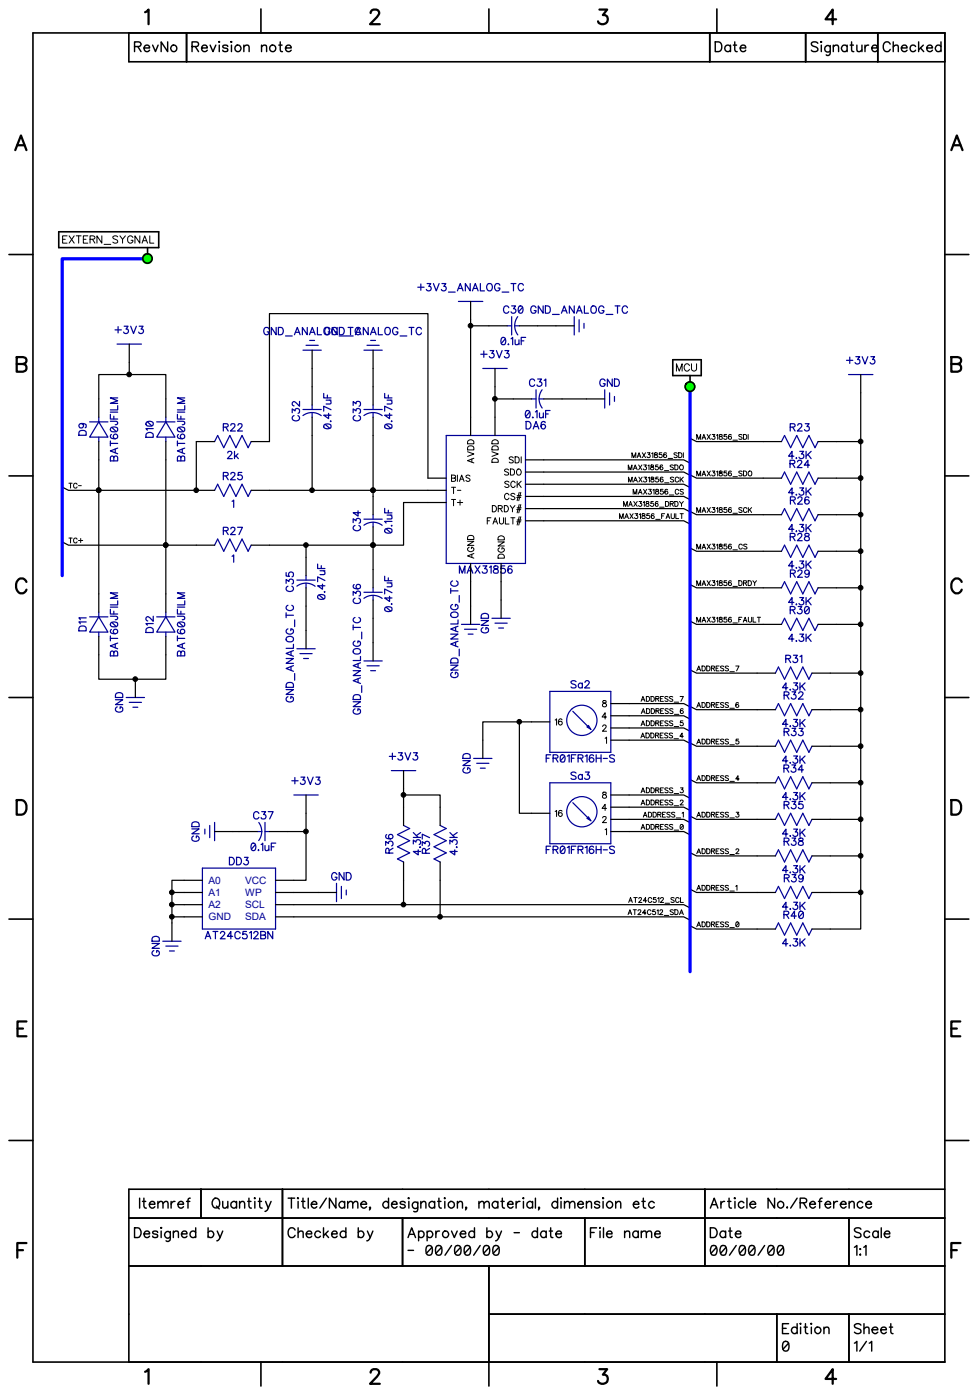
[picture p43: page 4]
A0 A1 A2 GND; VCC WP SCL SDA

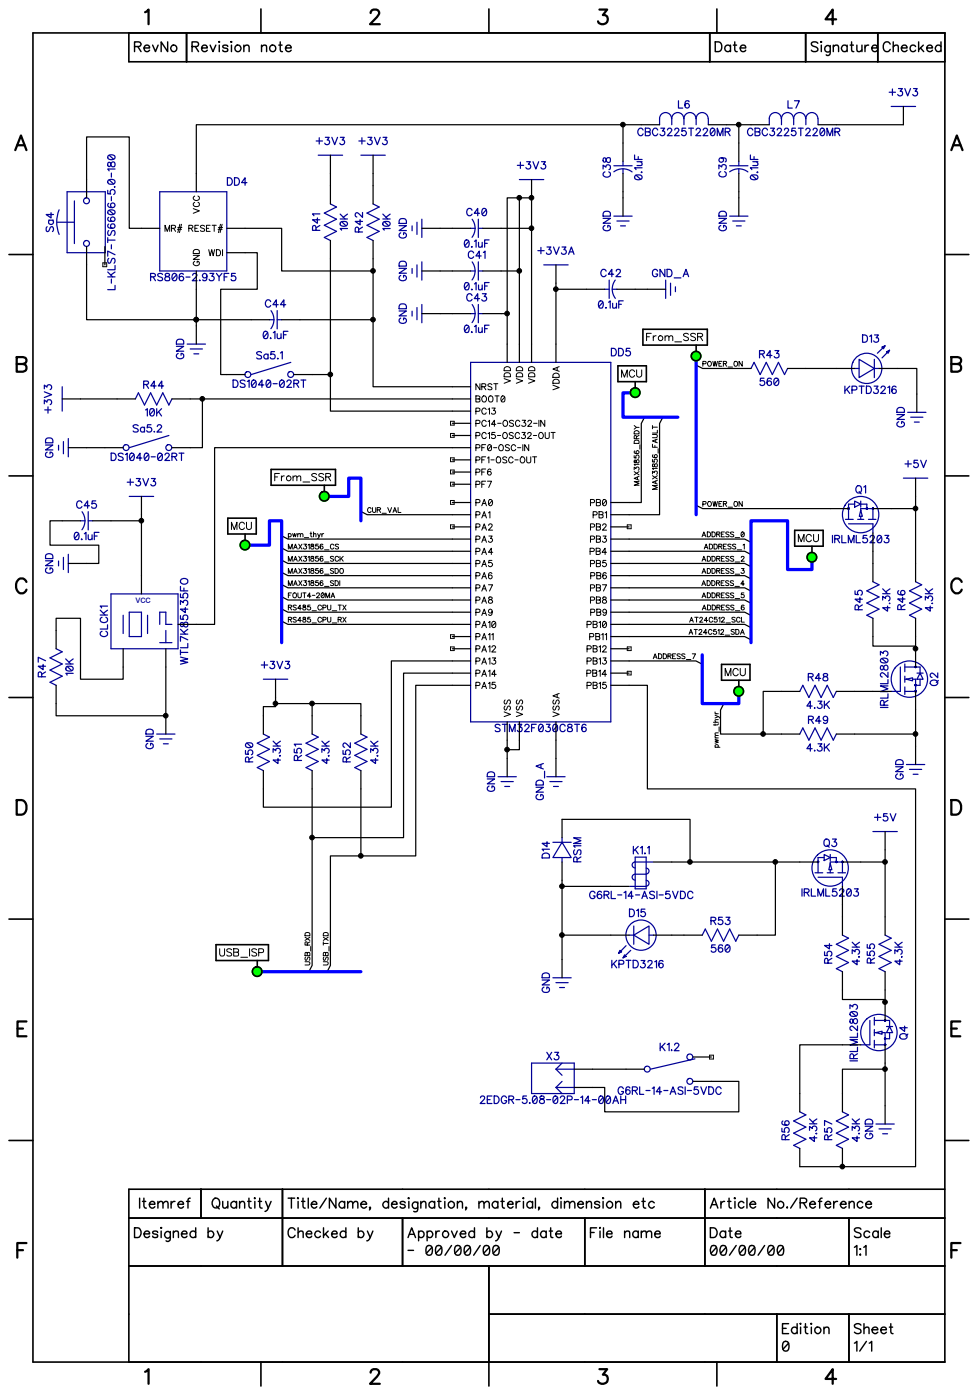
[picture p44: page 5]
vcc

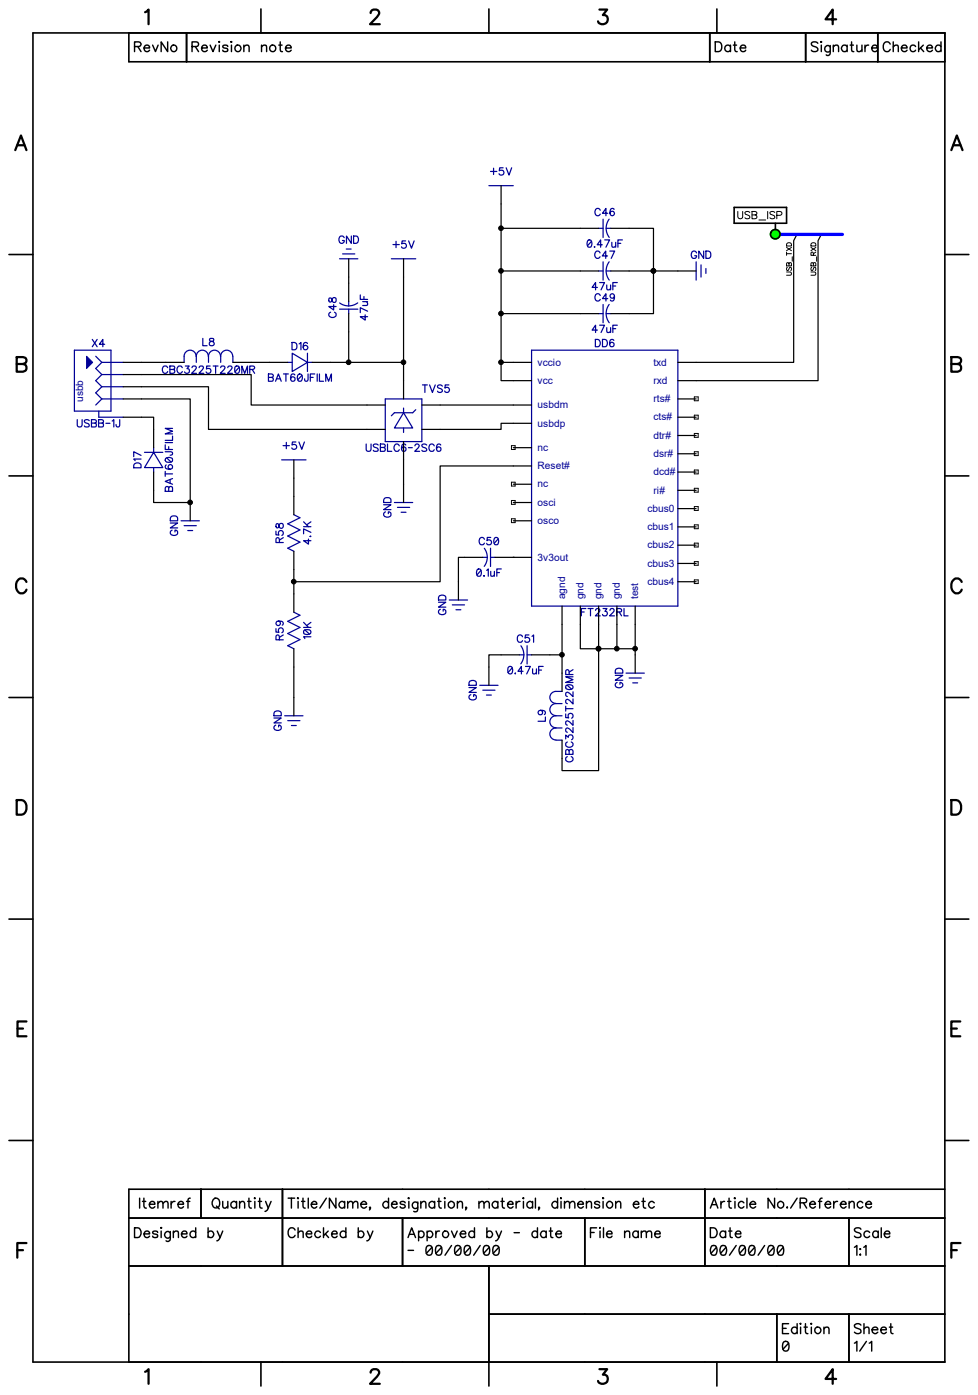
[picture p45: page 6]
usbb; vccio; vcc; usbdm; usbdp; Reset#; osci; osco; 3v3out; txd; rxd; rts#; cts#; dtr#; dsr#; dcd#; cbus0; cbus1; cbus2; cbus3; cbus4 agnd; gnd; test
