neuroandriyanov/TemperatureController-CH1/hardware/boards/схема_тиристор.pdf

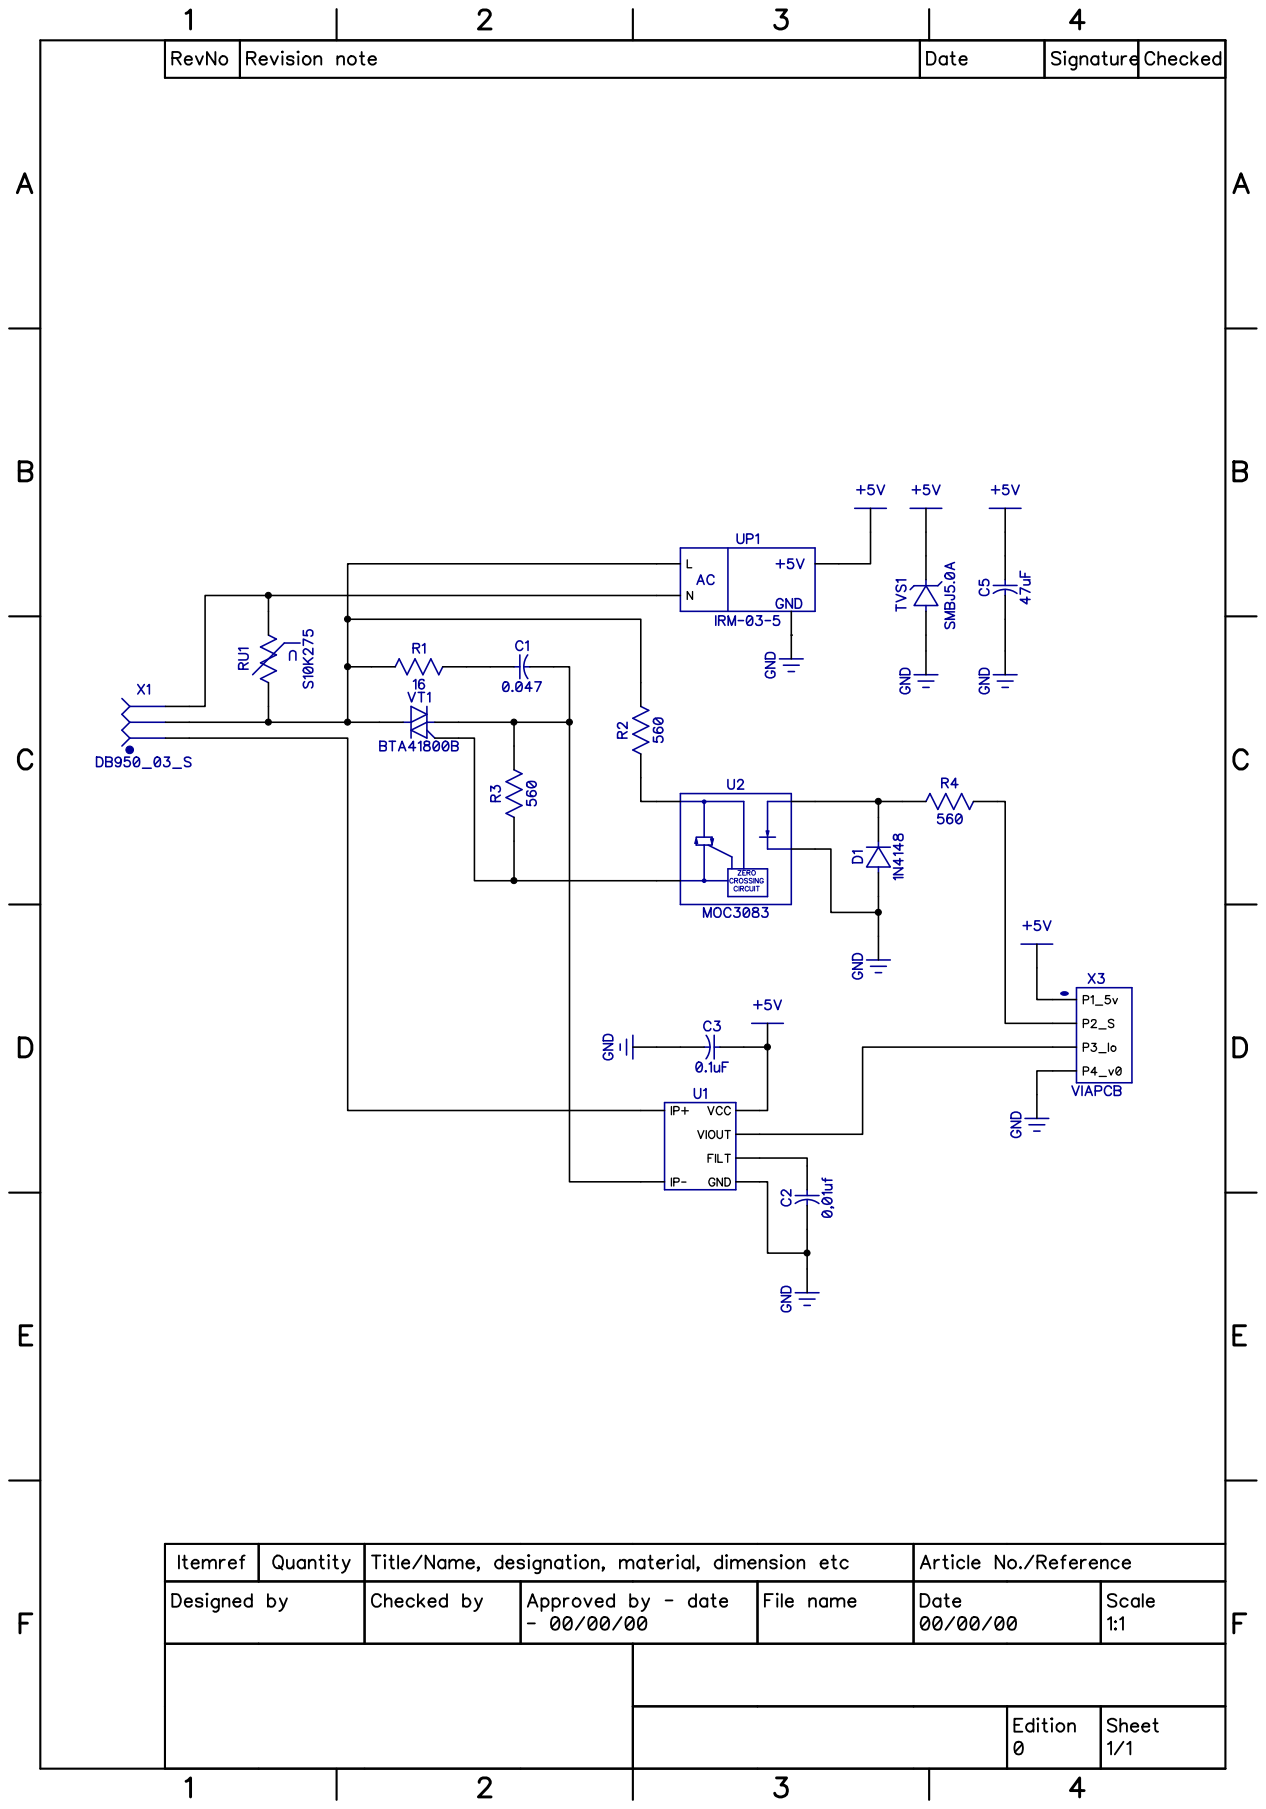
[picture p46: page 1]
