neuroandriyanov/TemperatureController-CH1/(commit log)

2026-11-07 Publish CH1 firmware, desktop tools, hardware and bench measurements
    [Board.gbr, BoardOutline.gbr, Bottom.gbr, BottomMask.gbr, BottomSilk.gbr, Bottom_Layer4.gbr, Layer2.gbr, Layer3.gbr]
2026-11-07 Pin knowledge sources to the published source snapshot
2026-11-07 Add English project documents, editable BOMs and measurement plots
    [Specification_SSR_P_V01.en.xlsx, bom_ssr_cpu_v2_3.en.xlsx, pid_analysis.json]
